iimarky1234/LoRa-Weather-Station/docs/Cheap version.md

| Components | Price | Quantity |
| --- | ----- | --- |
| ESP32 | 160k  | 2 |
| [DHT11](https://hshop.vn/cam-bien-do-am-nhiet-do-dht11) | 27k | 2 |
| [MKE-M24 Ra-01SH LoRa](https://hshop.vn/mach-mke-m24-ra-01sh-lora-module) | 135k  | 2 |
| [BH1750 I2C Light Sensor](https://hshop.vn/cam-bien-cuong-do-onh-song-lux-bh1750) | 35k | 2 |
| [Grove - Soil Moisture Sensor](https://hshop.vn/grove-moisture-sensor-cam-bien-do-am-dat) | 15k | 2 |
| [Anten Lora 915Mhz 3.5dBi](https://hshop.vn/anten-lora-915mhz-3-5dbi-70-20mm-ipex-tx915-jks-20-fpc-antenna-ziisor) | 20k | 2 |
| [Mạch thời gian thực MKE-M09 RTC DS1307](https://hshop.vn/mach-thoi-gian-thuc-mkl-m09-rtc-ds1307-real-time-clock-module) | 35k | 2 |
| Mạch ghi đọc micro SD | 15k | 2 |
| **Total** | 442k  | 564k |
