iimarky1234/LoRa-Weather-Station/docs/Functions.md

## Environmental Sensors:
- Temperature, Humidity & Pressure
- Wind Speed & Direction
- Light / UV Index
- Air Quality
## Communication: LoRaWAN
Node -> Node -> Receiver -> Local Server
