iimarky1234/LoRa-Weather-Station/docs/Useful Notes.md

https://randomnerdtutorials.com/esp32-i2c-communication-arduino-ide/
https://randomnerdtutorials.com/esp32-s3-devkitc-pinout-guide/
https://randomnerdtutorials.com/esp32-spi-communication-arduino/
randomnerdtutorials.com/esp32-lora-rfm95-transceiver-arduino-ide/
github.com/makereduvn/MKE-M24-RA-01SH-LORA-MODULE
[APM10](https://drive.google.com/file/d/1BAugwM-Li-jGMpyRHw0AnCDVwf6W3W4X/view)
https://github.com/kchwz/APM10
[UV sensor](https://wiki.dfrobot.com/sen0540/#tech_specs)
![[Pasted image 20261008172738.png]]
