iimarky1234/LoRa-Weather-Station/Excalidraw/Weather_Station_Block_Diagram.excalidraw.md

---

excalidraw-plugin: parsed
tags: [excalidraw]

---
==⚠  Switch to EXCALIDRAW VIEW in the MORE OPTIONS menu of this document. ⚠== You can decompress Drawing data with the command palette: 'Decompress current Excalidraw file'. For more info check in plugin settings under 'Saving'

# Excalidraw Data

## Text Elements
LoRa Weather Station & Asynchronous Wake-on-Radio (WoR) Relay Node ^2RUIXauE

Dual-Role Architecture: Weather Station + Low-Power LoRa Range Extender | SX1262 Hardware CAD Sniffing | Listen Before Talk (LBT) ^5ap9Bvtf

WEATHER STATION & ASYNCHRONOUS RELAY NODE (OUTDOOR HARDWARE ARCHITECTURE) ^zSuPotmF

1. Power Supply & Distribution ^BuRDiX9T

Solar LiFePO4 / Battery & DevKit LDO Rails ^SqDRI4YI

• 5V DC Input: Solar Charge Controller / USB-C
• 5V Bus (Pin 21): Feeds 5V Sensors & SD LDO
• 3.3V LDO: AMS1117-3.3 on DevKit
• 3.3V Bus (Pin 1): Dedicated clean rail for LoRa
• Common GND (Pin 22): Star Ground Reference ^p9uyle8T

DHT11 Temperature & Humidity ^n0Sk6EXF

1-Wire Digital Sensor Module ^xYWzMHa1

• Temp: 0°C to 50°C (±2°C) | Hum: 20% to 90% (±5%)
• Pin 1 (VDD): Connected to 5V Bus
• Pin 2 (DATA): Connected to GPIO4 (1-Wire)
• Pin 4 (GND): Connected to GND ^oXQNABsF

BH1750FVI Ambient Light (GY-30) ^3kpwiYuP

I2C Digital Illuminance Sensor ^3EP6RKSI

• Light Range: 1 – 65,535 Lux (Calibrated)
• I2C Address: 0x23 (ADDR grounded)
• Pin 1 (VCC): 5V Bus | Pin 2 (GND): GND
• Pin 3 (SCL): Connected to GPIO9
• Pin 4 (SDA): Connected to GPIO8 ^N1Z60F3e

Soil Moisture Sensor (A0) ^f5IFRlAg

Analog Resistive / Capacitive Probe ^zcOcd1Qv

• Sensing Output: Analog Voltage (0 – 3.3V)
• Calibrated Scale: Dry (Air) ~ 0% to Wet ~ 100%
• Pin J1.1 (A0): Connected to GPIO14 (ADC2_CH3)
• Pin J1.4 (VCC): 5V Bus | Pin J1.3 (GND): GND ^gcI2DZCH

2. Main Microcontroller (MCU) & Relay Controller ^uwbLJkkV

ESP32-S3-DevKitC-1 (ESP32-S3-N16R8) ^xjQM4z3q

[ CORE PROCESSING & MEMORY ]
• Xtensa® Dual-Core 32-bit LX7 @ 240 MHz
• 16 MB Quad-SPI Flash | 8 MB Octal PSRAM
• MicroPython v1.29.0 Firmware Runtime

[ SLEEP & WAKEUP DUAL-ENGINE ]
• Deep Sleep State: ~15 µA ultra-low power current
• Wakeup Source 1 (Timer): Periodic Local Weather Log (10-15m)
• Wakeup Source 2 (Ext GPIO): GPIO5 (SX1262 WoR Trigger!)
  Wakes instantly upon detecting distant node preamble

[ HARDWARE BUSES & PERIPHERALS ]
• Shared I2C0 Bus: SDA=GPIO8, SCL=GPIO9 (100/400kHz)
• Shared FSPI Bus: SCK=GPIO18, MOSI=GPIO11, MISO=GPIO13
• SAR ADC2 CH3: GPIO14 (Soil Moisture 0–3.1V)
• 1-Wire Digital: GPIO4 (DHT11)
• Control & Wakeup Lines:
  - LoRa NSS (CS): GPIO2
  - LoRa RESET: GPIO3 (Active Low)
  - LoRa BUSY/IRQ: GPIO5 (WoR Wakeup & Handshake)
  - MicroSD CS: GPIO10

[ RELAY & LBT LOGIC ]
• Executes Listen Before Talk (LBT) prior to re-transmitting
• Appends Hop Count & Relay RSSI before forwarding to Gateway ^2WJ0Mlcg

DS1307 Real-Time Clock (RTC) ^RmIEyMq1

I2C Timekeeper with CR2032 Battery Backup ^bt9r1vZ8

• Bus: Shared I2C | Address: 0x68
• Power: 5V Bus (VCC >= 4.5V required)
• Battery: CR2032 3V Coin Cell (Maintains UTC clock)
• SCL: Connected to GPIO9 (Shared with BH1750)
• SDA: Connected to GPIO8 (Shared with BH1750) ^qBBURwjV

MicroSD Card Breakout Module ^HC3TPzkw

FAT32 SPI Flash Storage for Offline Logging ^DgAPDlgm

• Onboard: AMS1117-3.3 Regulator + 74LVC125 Shifter
• Power: Feeds from 5V Bus (Dropout margin)
• Bus: Shared SPI (SCK=GPIO18, MOSI=GPIO11, MISO=GPIO13)
• Dedicated Chip Select (CS): GPIO10
• Logs both local weather & relayed packets offline ^TLPaZ0Ev

Ai-Thinker RA-01SH LoRa Module ^NChoNRZ7

Semtech SX1262 (Wake-on-Radio + LBT Engine) ^HYa109vp

• Frequency: 915.0 MHz (US915 / AS923 / ISM)
• RF Power: Up to +22 dBm (160 mW PA)
• TCXO: 0.0V (Standard XTAL) | DIO2: Internal RF Switch
• Autonomous RxDutyCycle CAD Mode:
  - Sleeps 500ms, sniffs 5ms for LoRa preambles (~200µA)
  - Triggers GPIO5 IRQ to wake ESP32 on distant transmission
• Listen Before Talk (LBT / CSMA):
  - Fast ~2ms CAD scan before TX to avoid collisions
• SPI: SCK=18, MOSI=11, MISO=13 | NSS=2, RST=3, BUSY=5
• Power: Strictly 3.3V (ESP32 Pin 1) ^ZwBtSDl9

915 MHz Antenna ^KllHag9v

IPEX to SMA Whip ^SqHOkuTw

Gain: +2 to +3 dBi
Omnidirectional ^IKiVA8Ye

50Ω RF ^9FIVsbce

GPIO4 (1-Wire) ^mhQojBEM

I2C: SDA=8, SCL=9 ^ryzXF8nV

A0 → GPIO14 (ADC) ^12SsMg8L

I2C: SDA=8, SCL=9 ^KdKrjUUG

SPI (18,11,13) + CS=10 ^Me33xTcz

SPI + NSS=2, RST=3 ^PoF2DYsQ

WoR WAKEUP (GPIO5) ^Nhw0Clew

MULTI-HOP IOT NETWORK ARCHITECTURE (WAKE-ON-RADIO & LBT RELAY) ^clV0jEVK

Distant Sensor Nodes ^jUGkhKC9

Battery Powered (18650 / Solar) ^BwNh4p6y

[ HARDWARE & SENSORS ]
• Soil Moisture Probes (Deep Garden)
• Weather / Rain Gauges / Well Probes
• Ultra-Low-Power MCU + SX1262/1276

[ ASYNCHRONOUS WOR TX ]
• Sleeps in Deep Sleep (10–60 min)
• No clock sync required!
• Transmits with Extended Preamble
  (~1.5s Preamble on 915.0 MHz)
• Guarantees sleeping relay will detect
  the packet during 5ms CAD cycle
• Out of direct range of Indoor Gateway ^UAMYDm7A

LoRa Hop 1 (WoR)
1.5s Extended Preamble
(1–3+ km across obstacles) ^59qEiON9

Weather Station Relay Node ^whQdg7df

Intermediate LoRa Range Extender ^VjacY3iX

[ OPERATIONAL LIFECYCLE ]
1. Deep Sleep (~15µA) 99% of time
2. SX1262 Sniffs 5ms every 500ms (CAD)
3. Preamble detected → Wakes ESP32!
4. Receives Distant Node Packet
5. Listen Before Talk (LBT):
   Runs 2ms CAD check to ensure air clear
6. Re-transmits forward with short preamble
7. Local Station Action:
   Periodically reads DHT11, BH1750, Soil,
   logs to MicroSD, and sends local telemetry
8. Returns immediately to Deep Sleep ^qwQfbzJC

LoRa Hop 2 (Uplink)
Standard 8-symbol Preamble
(Relayed + Local Telemetry) ^m4u4vdSg

Indoor LoRa Gateway ^Igzptiyn

ESP32 Bridge to Local Wi-Fi ^s0xBVVWQ

[ HARDWARE & FUNCTIONS ]
• ESP32 DevKit + SX1262 LoRa RX
• Mains Powered (Always Awake)
• Demodulates all 915MHz packets
• Separates direct vs relayed packets
• Appends Gateway RSSI & SNR
• Formats JSON Payload
• Bridges packet to Local Wi-Fi AP
• Publishes to MQTT Broker ^YW7YlnF3

Wi-Fi 802.11 b/g/n
(TCP/IP Port 1883) ^Fo1SAf4b

Local IoT Server & Automation Stack ^CcyGbGPt

Home Assistant | InfluxDB | Grafana ^f6NIfh1J

[ MESSAGE BROKER ]
• Mosquitto MQTT: 'weather_station/telemetry' & 'relayed/nodes/+'

[ HOME ASSISTANT ]
• Entity Tracking: Local Weather Station (Temp, Hum, Lux, Soil)
• Entity Tracking: Distant Soil Nodes, Garden Beds, Well Probes
• Multi-hop Diagnostic Entity: Relay RSSI, Hop Count, Battery %
• Smart Automations: Irrigation pumps, frost warnings, alerts

[ INFLUXDB & GRAFANA DASHBOARDS ]
• Multi-node historical trends on single dashboard
• Microclimate comparisons (Backyard Station vs Remote Garden)
• RF link budget & signal decay heatmaps ^0TVC7NdA

SIGNAL COLOR KEY & ASYNCHRONOUS WOR / LBT PROTOCOL: ^7EgTakqk

• RED ARROW: WoR Wakeup IRQ (GPIO5) & 5V/3.3V Power    • GREEN: Shared I2C Bus (GPIO8, GPIO9)    • PURPLE: Shared SPI Bus (GPIO18, 11, 13)
• CYAN: 1-Wire Digital (DHT11: GPIO4)    • ORANGE: Analog ADC (Soil AO: GPIO14)    • MAGENTA: 915MHz LoRa RF Link & LBT CAD Engine ^yA0SkdjW

%%
## Drawing
```compressed-json
N4KAkARALgngDgUwgLgAQQQDwMYEMA2AlgCYBOuA7hADTgQBuCpAzoQPYB2KqATLZMzYBXUtiRoIACyhQ4zZAHoFAc0JRJQgEYA6bGwC2CgF7N6hbEcK4OCtptbErHALRY8RMpWdx8Q1TdIEfARcZgRmBShcZQUebR4AVm0AZho6IIR9BA4oZm4AbXAwUDBSiBJuCB4AJQBVAEkADVwhAFE00shYREqoLCgOssxuABYABn4ymG5EycgKEnVuAE4e

Ze0EngA2AHZk/eWADhHknYS5qQRCZWluZLjzoshrZWDuCaeIZihSNgBrBAAYTY+DYpEqAGIxgAzACMOx4uEGkE0uGwf2UvyEHGIwNB4IkP2szDguECOWREGhhHw+AAyrA3hJBB5Kd9fgCAOqLSTcWEXdn/BAMmBM9AsioXLE3DjhPJoD6dCBsUnYNTTNCwsaKsqY4RwerEeWofIAXQu0PIWUN3A4QlpUuEONlzGNdodnzCCGI3C2h2OIxGF0YLHY

XDQfE+IdYnAAcpwxHyEmMeDsxjstVsLoRmAARDJ9H1oaEEMIXTRO4itYJZHLGs0XIRwYi4Qt8nbLWFHU4dztBz5EDh/W32/AXUHo73cEv4MufPqYAYSAAybGquFQnJC6iYqAZrbDqAAZKgAILMGAcbCSX4cYTMTe4AHOTjOdeONioAAUnLXAEpUGqIJcBgVB42IJALU4KA6UIIxxF4LNPmhaCADFcH0GkNVQfl536U8iGUcN0DEHImEpEMoHMAgC

OuYiIEw4hiDectQiCQhZRmZILj0HJcA4pgbTQd0x0+MFrg4ggABV+kqVd103bdJF3fcqM4Y8zwvK8b04e9H2fV933Yb9f2qACgPwECwLYCDKUHBAAAkrhuJccPiR4lRaKA13COCEJ+IQEGzHEsEqXAxkpSRQhkxdlw44di1LILPnICgYtciAICKABfSYSjKCoJASXA4GWAAhegoGhSlugQ6BZIuYY0HGC5sL9C4FmIJY0H9LZ4mSLYtmWE5kgSZZ

Tg8splOuW5NT62ZPheMUdQEH4hTxMFIRGM4EiGylUXRPVsVxEFNsJcgOBJMlsgGC0aXpRk6olH0BTWrkeT5V6OWFR7KmeylpUkF1jRW5VVXVPltQuI6DSNApzWQq0ECE1ARMdY7gZHD0lS9ItUF2HYM0myBozDGZgyYGMOHjK8ENhLYuwSUaeGSUGc3zYI20S2dkqVCtjurTIbvrBGlSbFsuZwjsu0OHtlj7cd4qx0SlQnAE8ZnOclQXDLcyEAg3

xBBAz1ESQ1AQbAoBEBA0C3VtlNIPcojUjhUAAalQVcKGcAAFNgKF3eSN3XDhlGN1pF2yCDHYAHz3RpYW2HhUAcsliAoa7UEBU9cz3DhCGhalQ9QOO4u+bJUDKhAUMCVApIIP5v2XMqpL/SkUJyWD4L5bjkLQjCsM+vDF1oojKlIvpwQp0gqPcUf6MY5jIM+VEwnsvlcKVXiogE0gUbRsTSAkjhpNkiQ9YN6ojZN69zct63baUlTncPD2vd9/3A7X

YOXnDyOQtjvHROWxk6p1IOnTO2dc50nzoXDiygS6exzH0V2Vca7G3rvgRuX5m6tzsgJJyM1XKwnchcLyPlWDdzQAFXmBUQpNXQLgWEkVor9DikOacSUpSUHSpULKpRcpFHypAQq6BAiWwAPocAcgARTgBwEYDkADiEjUgXFqpUcRURQ4sU+Aw1mrUN6g06t1KWLVPjTRctwQ4yYyE6IQqDQUAINoEnQBCYauBkiaEOPtNEGIsQ4hcZCaEhwSzQmw

O3e6IoxRfBBJKT0b0EDci6ryCMX0hTRKenEl6KVhAyjlO8C4Ko0QQ01FDT4MNDQiwtEjfeo50bOgKWgYRXR4AIWSE8QROMEBTjQFsVm/pljTypuTKMlMww00TJqPYOxjidkOEhJU7MCy9NQJrWhKJKyC1rLkeGjZmytlWfCTs3ZCby1hP2VWSthL1IHGwScGsuGfA4hBBhEBcA8BYcwdK7CEprKSjlPKzy8YQCMHSIQfsoD6FQjVNpvQGp6O4LYz

42FE7EwgCY1JqBDhjBGNoQ4ax6aJGWDsLYu1IxKksbNXgJCFqeXsYUhJ30gkSAhLCBAawvG+MOgEk6+JegXSuuSW6yEom/WZNktkiTkmmM3mUJxP1RRZNZOjfJrpGVKmKWqWAkNQaVLhmgBsiMMLIzxgfJUvLMY3OxvKnpeNtr3BOMMsmaSxmhjjAmBCu0TiwgSAkAl2Y8wrMeTzcsWyazCz2Z8cWhy8bHJlnLBWA5rmo1uare56tOGhuHhlTkrR

TxSQcq0aoe4pIFvqAAeVjBpU8dIACasZAQOWqFWittQ6SAVaMuU8dawIVtzK0b8bapK5grRWktDlTzVFzJyKdg6p1NvqFJVogIpK1GqK0NuUFO5+XbNuqA6FML4FReo/ChF6LBGhCKpUlFqL4HnpUReui+ZsXXpqdF29+Kyj3matNZRxL+FPouSoeaC1FpLXSMtUlK3VpPLWhtTaW2xjbR2jd3be3IYHUO2oI6x0TqnTOudZ5qiLuXau9dm78Gyk

IVYzUpDFpCG8kBSh/lSCBWCq8sKaiLGsNiim9Z3C0pn3QPwsAXTijAs0RbKAEilHQmYAkAA0ggBIKiEiwp6BILRS1l5KgYVsUGqKyUdQ+s1LUFwqXEOM4tBlCp0nONOq4iAEJiAkrTFsbl/jKwsrcdCauyRsA7EibSTJf1JX2aSaZ3gEXQsSpVbkvwQMmmoFBlq0pOFylKn1dU411pf02sgJa5LLToBwrQB0zo4mBB2t9H6lmcqSbjM4KMm9TXqa

ep7sNBZOwRjLDZkGzmqyBMr3DULOsUaxYHMlvG05vYLmKw4dalWZQ1ZDaeUs+hYURhfJ+fxgFAigVLJBWVIQ07CCNGWFJDTdUdaUgYWmQx0ydgmZSTMEYhxtCwmSBcoaCIyUgPRZZmYtL0U6Y1fKxJPnnOrHGGMXTZQDpeeOlDokl1STCuCw9JVYX4s42lVFhrXxEmxfFOFhLaqQZFPBjqspeqsSwxy0qS0Jq6kFYgEV9VS2BQ1bQH6v133nXNdd

a1917XaZJnGh2cYIxFkFQGwgSWw2+ajZ2YzsoMbpvS1m+cy5K2U3mpWxmtb2btbCYgCQ1AfsA6O3BXAHwoETy5mQUfTQjGyb7q7nTZ7fcciHsHpqU9I9z3jxuuRaes8aLB4kE++HKJX0CSTDxaCX7BL5eW5AADkl8C8IkBbq3Kkmz240k79khBXcuyo45Zy1KQdkMYxQ3d1C2MbPKJtiQuB1MWd41AX5WatZlFSjnkTgKhGSYkHSAAjrmao9QRh1

vqNd+FwHGrcAeyimYYxCeYpmD17Qsz5bbWTCS/7Fnq/ENB7ZlLEWocQkP7tZYnmjqBMcwK4k6ObqY5J7E3HEPvoyqxYTgql/v9KqklpzlfmJNTqiplrqPTlUhNmUMznlsrA0sQFaqmmzrjKvumFsE6m6iMsLmUKTB6uLs1KzGmO9oNIGhzArsbv3psgLBGuNoaqLOrlNkclrrLGckmlcothgenhAKtiGvQfVMBuPiCGSEgqhAgD7BWiMKgAoJXK2

JPA7qgPmPQIpmoJ7KOoBPxLOO3NBJ7nyBSogf3Eeiejmg+hIBPGHm6hHvelHugDHr4mvAnmUknnxLvKzgIZnifNnmbnSBIY7HFNIbIfIYoWVMoUwKoeoZoVANoRWroTSHkAtlXkQnyPRp5PXsxo3qgDQhxqFO3h5l3t8mwntibgPjwmbqJuJsIuUCCqVEIEqocFduomVugLdivmgD1o9rwHSmUNvuVr6vijwGMN9v0ZAEDn0h9mcHYq8A4tfi/qy

uypypoI/ryijoKu/hSHdCFuKqTj/qtH/gTjFvsd/vEhankmAZTpASUjThlnTvqPASwTUizmnqgegQbtVqskzN9imILsRCYY1qLpMghKSkzH1skEcNQcGn3i3vzDiNspGi8dGuwXGpwYmvNsmnwV8YIUbsIS3rdhIIAEQEqACQAAamoYCKgPUBwHAIxmgIEZZI7ICFFKQGHFnNBL8LSLuIoe2mVM4ICAADocCkkUmVxCAPhfg+wcQ0p/hoDSHegPj

il0jZCCAsAaR0i5zLijoimknJApCUk6kVpoCngACydIsIVpOwzgBpyQqA6ksRagepqAdplJJ2UpMprssI8pah3o1EhYqA2AwQ1gqA5ANIayYIns38LpwI+g+g6kSisYuc0pspPAPAvp+4jsSivKgE1cTA2QiYHuuRVp+6fux6dwgeUAVh6Al616RBTA9hNZDEJAS8Lh7EnEaAQynwn6Xh7xh8x8QGGUYplJuY1JtJ9JUAjJQRWcbJHJwIOQ3JwQj

sfJdIApwpopZJ7pkp34XpcpCpdqyplJqpl0YID4J4WpCRLpbpCRppFpVp8ItpKQDprsTpUA15hpEpnpspPpaA+YjgeAgZwZIQrs4Z+AkZwRMZm5cZCZrsSZKZe56ZmZUQ2ZuZQEfm5IRZ2JaRtGbkEx7y2RvkVCeRzeBRbyuAQWJRu2fBSulRQmYhw+B2o+R2UmkirQhwMAZUhwcA1QMiEiD+bRmmYi0mYOXR+MhmdwyKSogxqAIw5mFiZ+fIIwF

+8x4ORx60SxbiYwY0g0AlK8fiT+fKZ0biFs0IxA0Ineoqex2OcWFxv+Qo/+LW9lAIwBZOlxiW6BqWUBuq0McBBqJorBkASBpqKBCWjS4BJWGi5WnS3OqyewpwOKAJTlwJVMoJ1iCQicPA9MVBzy8uiu62COKuyJAV+yEsHBJyXBc2uukAg4fyuJQhcJZFYUPiVFZRNF+2Ymh2BUIKHAYwdIfwWwrQjQMKglN2CKem2BvRA0QJGKUWiQBp/Sw0jMf

qg04wsukxilEYteNmqldmTKGl/KrKYwZK0IMu6x3mml0AWx10OxVlWOMSIB+170r2AeT1iqD1blA+VxnlVOdx0BjxTYzxJVuWIVXOYVaByWuJWBzUywGVX2SVhBKVEyHW769M4wLM/xuVNB+VFRDBiJTBuyKJk2ZV6JFVmJ1Vgh+uf6NV+JjVOalQuYDkUkVpdcmQiA5AVstcJ4DkQgjEEMxZxF8IZZA8FZr1puQedEIeZEU8dhd6zZzhrErhnZO

EH6yefZoVmqR8gG/hDFEAjNzNsIrN+g7NrY1sGkPNfNOqqRNGNemRZQ5CORxF+RzybejCellK3eve3MIhg+1RI+pQdRoiEAmAdanIRgZpqczCo1S+9ZkA92El5WCyL2sqZK2guKfYNiY0CQaYvclKm1Ktcxy0ixh1bid+e0rEPKF1JdV1b+N1sdVIYqNlBxdl6lz1sqpxTd5xOS7lFOalYMf1PlFSflauQVtS/Z7l4Vbo1NXwPOvAx+sIhwCN0W+

ByNpBOEqYTMhMpKM1yyg2BJYajBY2hNwNxNsa7YZN3BWJvBdV09DV3thJZusIzg3ItcTuqgUQ4FJ56pqAZpNk9oseVIhhJZM1HcB6ItFh4t1ZjhEANhMtIuTZ0DCt+lStdMoMvZ363hRSWtWeQ+5uz9hAr9EkH9e4apUZv9xA/9leNtxCdtzwhFLG3AztG2nG7ep4O2bVfytFhWVRutNRXVIiIKbAjQMisYp4ZUzAI1847Roh9d92FN2EclxiUW9

wcQ2w5KgO+dfqhdCxb1N+Kx40axFdSOz+1dqOQqH+ux91yqLdROxxL1OEHdH1hx7O31yWXlA9tOvlTx/lRqTOY9GtX1GMkN090NZJuwJwi9K9Quy9IuqVKNOExwICmVSdWNsJ99B9+NR9I9EAGu5VCal9FNtVATNNDydNkDlQpJMkxtCoAADdSd5GSWMHU9+AAI08B1MARxwW0RhjAACkeRn4fW/TX4LTCQvTf4Lpe5htX45JuYuYvpC5sols3oA

zW5X5kzaZ34uYBap4CznASzgZDTSiPsla8hX4T9L9CAEzm5e5Zz8FezHABzKzRzyZBhO6gthOoD5Z2EudZQOszZdZFEjZctiDrZz6CO8eyt3ZW8atGD49/62DfhuDlTbNtT9Tn4yYzTIz7TgInTKcvNPT/TDTQzrTYz1zpJUz34sz8zaAiz0mzzGL25zAGzrsycX42zZaDzTzxAqzxzpz34FzBDVzLLsl349ztL+z9LPLLzuYVD+d21WRTGRFrG7

GLtLDjCZU7DfG7VuN7OPDGUfDzF3VrFMmy40IqEcAAAUqePoAAFYSJfaL5aYiUMpiUGa9EZXooyWKOn7pGajKXaN90Ko35jCubvYtX6WV3I6XUQjQgwjmVIiWOuXOMKqOWI22MZJnGPU93XF91pb3FagA0M4IGj1vHFMuNBMRVPCtJCUVZMXdKrLDTJgwFI3RMzXEFi5TLYrjS9a+oU2720H70jaH2q4ls5Nonn35NVULY31s533/K6svKFGMKAh

as97lFhD+0SYsUSDJB/BwALB1oQpOsdHjVDCTXr686pjJ1Yqpg7B74djJD+gjB3vJCBi+u4VZW0PvKX6OKQ4xtWkJAqbu0QtRsmPGU11o512f5ZufWt2Rb2OAHE6wfOOAw/W3Har/VeOA0+OBVUj+Ng0T0Q3gFQ2z2+pjTDRL3tttZpU9SJDHA7T9bY10HwlFXMEn1sEk2Tva48F644m3203pP00SBlQOTwjJioTkn1Bnj6CaCEA3RIIuRit1q2l

jBbo+4wQlne5M5mH+4OOWHQOwNAszwguS3R5gsAOrwdl0yq2eFwvlu+FDmVCifidjCSfSc2tycKdxRKdfhKIqeszqe8E4W234UO3KuMOkVqvLvvKyutXaucMFXcP0UGtbuB0grJCtA+xbDVCKZ0gL7R2Ehntx0XtKjYR+pb4E6zL4oMyJAL1/EJDbQfs14qVF26Mxtl0gdx5gdGVOZmPbH13UjWVOM2OpsnFvXJs2NoduO/WYeD1ZbD1jvBWYPg2

fEhOz2jFZWw1UcAm0eoA9aHCJwErbAwl71lOFUjvFW+Ocdn3TIX3TvYmzsCHztcMyOVD1A8DUlv1qAEA0m0i82SS0wkOnlwOmHvN0wgO6ei36eQPNlGfh6mdjzmdMTgtx4oOQweE7z2eEcIuDk60ZQfdfdEO/f1D/eYQnxA9f2bTW3yvfvhcMNN6qvMMxe4DtDxfrs6s+36t8Jpdj7oCxiwgABaBmqEyQADUVp7y+iK3R8jSKsxnwMlqYYwe+Yxa

KzXrkfoe+rXOjeOzKAHHKBj510bpj11GOSbKHo3+OiHjj1j3dgTvde1mq3lnjQ93j2Ty38LhWlYa3mBs940uwA0O3UTnbCEh3iQCI20kTSyeVLHGTVYBN2TuTpNU7OuM75bL3SXb3JJin0guhocNsOEqAgAyAT4znBMwJCexCCYDfiAgEBl4c3ejks0mfdnhMSBCugKiYAszfg5zT6oCGWN8ivTPkmAi4u85MuIKIVivJm+nwUiv2lfh0iAjLhct

Su8snMVrLAitnNam7MSuPNr9HMb8Rs6fg8bzC3mGVkGdme1nVz123pzygso+WeQsITQtlDoOp4OeItOfZ8+e58hww4moYvqX2oDl9K+1fL8LXyICaAG+xAJvoT1b5kA5Qnfbvl+F74loB+8AoflS1H6+lxSHpSfpsz84z80Ac/G5rKQX5L8V++/bluv0rRb8KBrsHfts1X7LNpWn4PlhWhP58cQuNDMLvQ1yJMM6E6rd5JIw9qlEEu53ZLrg0NYB

0+e7OaTBIktaaAHIgIZIMwBYAOtKKUjISooMtiiVpe4lXon6CUb2MfWClP1irW15Bt/21dCEGSk8Shsje4HJzLGx2B+YEAOgpnI3RG5294OabGJs5Xeq28AYrjcAu4zm4u8FubvJbgR34IfFis1bUrLWxiqehZ6hwDsL1CD6xNV6XbUYoGD2CJN1q5QGPkO2VyXd2O13SAEn246VVU+j3dPoJwXYiEl25FJRGuy9otCEAvPHdugAsr1BUI1Qe9Mo

BPZvcxKa+Mrr6FWA3tgcBpQ4ONAhIvtMhWoSjpYM/YKt7av7YuhBwhDJBoQSTT5EY0MqbFa6ZvO6pN38EZs26ABG3jjim7hCbiTvDxg8Ww7FsiaiBeIbiQ5xT1feqyQZNtApodtkqDAGjvEy1A9ZGuZKf1Kd0HbSCIACJePlkzHa1C7uKfXjjVSppztmhr3IkugECIRlf6yCM2lT0djoC1ObzTToLW05g8wGl/MWn8zPQ38YGoeUHsCQQbMikGL6

dHu+kx4p4f03/PHrgwJHgUiR3wEkaQzJGngKRNPKwZsLoZKsGeJFJniIJZ4OROhG7FvL7V4a9DjWEgIwNgArTYBiAsIGRPQDGGdEjBkwqYKvnpizCtqcQGxGcC+wvtCYb7J9ur0Tw7U2uuvA6rsM64uDeur+KDucJ8HDdQhEWQIUh2+iXCwhHlGbhh3SyFs3hQNaofhzLY48velbX4QIVCazJfUV9BsqLhBEds9uwCE4BlXTD9syh8IxEUiSqF4d

URUse7g0OvpNDSmQncphIFPB+E2ACCHIt8EICMAFCWcEqHcSHHGwfYvwTQAA1AZGFNQkPX3OAyHiw9DOrI4zhyKR5OELO7ZN9Blj5Hq1MxyoH/vj0qA9iCAfYvMqwEHHDjFCtfanBOMtzTiAG9kahhkQEGKihBUXZnuRQK48ZJBHPRLrq21Gpd6227PUegGUDYAPuuYQXk2gtHFdg6q+WXjLzMGmJWY6wCaJ6N5w2DHewQvRgby5THCNil1frtB3

N6d1s2wQqMXcNspXDpuEQ2bkmJbYQBsscQjMQkNW7BM/heMElJsGOA5CixcTNeo13pgLDqxzHcoRd0yajsPhNQidmiJ46FjMR/HbER2O6FVkKmwPVgMXArSMZJyppXsQgnJIggogHJL8GMBAFukm+0A+vrGj3DuAC+uYUgKBHQEEMAIAAPxSxEtPwW4eIl5MLa9MRWlrEhNM2lFsDDmnAjfhch75jkeAEiJtMkCb57kQp2gM5iPzH5rNCBccFKSQ

gX7itUA8FSkfOJwifMoePzKsgCzv4bjEeC8HcYrWs4rADx2PTiZrSFFm5SSX9eBKgD0myAGSZ4IyagBMn4AzJxsCyVZMNI2S6+sA+yXSEcl/kXJPfdyagC8l9NVmfklaQ8SClMDUAqUsKWp1oGH8oplaGKegLikJSHISU4KSQnSl4Dx+X5Iga7FSn5TSBhU15rKNwryiCKn4p2t+NVHkVLWGoznlqO54SA5B4EgRiawkT6BLWS/L7ICH0ASIsqYw

7TK6yMFMwE6OEazNJSiyVjsJ+3d1t6J174SY2iQfpAgEMaRtjGQY1lNXAOGFwYOlEuDtcIQ6mIZqQBC3vRMeF5tnerw13jh3d5fDp6Pw7gJFXaJ1tOq6Q1ZAlQzDv9W2gJXbuCP6T7A/QCyEoQOxxoiE6xCfFEQpObHojlJlNVSc9xxGZ82hYURTEDKAmbswJ6XSoEIAoCaBlwlrP4H8HJIISpeE1XnOYimFPZ7RslMYOsF6wZVZk6ZNRgDnxlfs

wu2w9rvYPZTjBcA1UYiVXQg5kTQxiBXwRGLeo0SJunMuMQ7wgLPCohfMmIQLPYnIEjxIso8aExfa7RsZQkl1EEPllljlZmQnFIbI1mx9h2Mkq7o2L1kzZ6hGIo2U93HCmzdWeIqoNoB/pfof65gX4NvCXK7gvwZpQELUAAgngLIVkBcmtB5JsjAGZ/aZBfz06E5/ma46WjVMf6cj6pyDRqbyJ7Kwsv+R4xzqeIkBxBp5spM0nPPuRckQQy5b8CvL

XkaRN5oEbeYvL3mvjaeH4hvL9JVEiJXa7yZcFbPhEgSeetshQZgFtYyIzSIwIwMkAnwezZGSKH2TaJ6aVd7GLMPqAzEJhZU/UpKeEDNSmIF0iZtgvXvYIDHJzjeqc03hYwuF5zIx43X0S5T4Xk5c2eEjPLzOTH8z3hHHUthXNamBNJ65bUJrDVGgsTgR6bUsfE0DCAc9gMuWEZrNY6VDj6aYpsQPPJpp8jxGfceWblaB0gfY9wZwHSGSDOA3ygIZ

wNM1sX2KeAji5xQLxy6HAgutIkqYnCPnQ8T5TIrcSyPPkI9L5kSrkRCx5H7j75dnR+fIozwnjcGnihxU4pcUIANCagNxR4rsXZLfF9MaoAErlZyi6eggmBS3nNnt4zSSCzsXRVkG6jIZr8zkJazGBml8A2AUYYV0l6ELvZKEvol62UbyxtABmSXBoysHuitegbMRSzIImrFAxpwkMTwrDFWN7hVwsbtb1zlMzUO3MxZfmyw5SLUxeHD3uWyrlpKZ

6HBGZL83lkliwRa9MlLLFhoyx9FXcioT3IbGlVbu+spSYUyxEmz1JuIs3PkCzjjpB0PsFtICFsX5dYwSiDSGaVaBmlx0vaU0C6UaAoJmAuAAAHVqF9Y+AQUmCGNgOK5O8RZcI0B2CoAAAArwHGA/0HIRgF0vTB/plRUAMifWMQEcUnNUAqESyMwEkCIJDg7KnqQYPAo+w6Q1Qc0i6U/nYBfgPsGAOoHUj0BaU6wSyahAIb6AM4tcaoNiCohZARSI

pCFXSGXCtAsuGkWdIplaC1AfYahWoKeGXDOBWgiK+oLGEHSYrNy+YBAHAD3DBBfVTsQ5GgA8m+pUAAAVtPCoB7QRIZwKCAoCoA4An8R2NgBEDCoXSnIJ8AgCbB7hhAogY2NMykiEAsgpAX0j7CYDsAAK0ZdwIpHthfwEE5zMYO4oSD6Am+magEDmsCIiAxAvAb8BHHiJcDZ+G/CvovwThJxNwa4OuFrTDikAAAhNc1QD6RwgqADiN8GsBQBj00ap

Na7Agh9BLY3UxwGupyCowbIxsOAIEAwiaBggxqjgBCsnTTpZ0G6SuO2lsUaQfYxaeoD7HAxOqO0XqzqWyRWaE9LJHpRktswAC8XAxenuGX4QaN+ywAVtqAUCw4/gzKpvnSAA08tUIdi6TiBug2KZYNJ0qDWivy4EaK0pZH+vUDpAVpSNX2F0nSCnRng4pWcS6WQOik782AhIjjeKNrhjAi+BpWEOSSb6CtCG79AgKxv5bssmaVpGyT/PAonh212a

v1ewnCDIARSi65wNGQUixg6QHaKAXSCHWVoeAam1ABpqDido6QrQKSOJorQL9Tw+64cV7AXUmbNNG4MqO2jrQKB6gvFazSOtMhLqc13NawEaCigAgnNGm+Vb8EvKAg6Q1mrUDeohVoYe0GkXBJ7ArRKJ6g1JP9agAjgWxGMy6suCgkrjVxSVdcBuE3BbgARz17AR2A00CDOAzGmEGQPAhdKng7cUcB8A5BVCckDVQC4CKBGqA6bpOM49BBBV1WOB

i4RzQ5BnGmAC06YZUpcfSNdKVToGgLGJZHivnP9dxbhVAHLJgYPyBRT8jJeCshVPqYVFaOFYNsRXIrUV6K1AFluxVql8VhKg2MCFrjkqtCVKmlfSp4CMqI6LKzcmyrNIcquVuAHldhv5WCrhVccUVUDvFXEMpVMqs0nKq/lKqVVrsNVfEA1X8rtVuq42PqpyDFqEA8WvcOastXybTwNqu1Q6qdUuq3VHqu7S6R9V+q6QAa5nc7AL6hqK+ka6NSNP

IBxr/Yia5NUGTTU3QM1WaztXmp7WFrCdpatAOWqPg2RzA1a37nbB3CQUG1WoZta2rF0drmdku42Gy37WFSN+BmitCOrpBjqQEE6ktFJGnVMB51xmhTQ+FXXaIN1oEJsOpF3XSYD1yCddSeogiJqL1sna9RwBNUpwCMj6wdG5os0doTw76mfF+uLQ/qGdm5dDddB5ZAavyoG08KRqg3UDSN8GxtWMCQ3agUNRgNDRhv5Xg7cNS/fDVwIXrUAf6FaE

jfXv5AUaqNNG5IHRoY05xAQycRKbFvY2cbiRPGvjZ9kE2sr8GImn7vgGs1nN9a0m2MrJqtXi6lNAkeQMZtM3fwwIOmmvvpus1GbXYzmszRugs1WbjdlaWzfZuNiObN9Lm59fWk83eaL9ZukyJOoU0BaU4QWoVVmrC2zyFVbAKLTFpf1xbQ9t6ztOhmS0txUt6WzLS6Ry2pq+gD4ArRXDQQlbME2CXBJVoV01bPwdWhrWoCoihwWtbWnEB1q63Age

tG8vrYBEG2oBhtJWmuGNu6mTa+g02ypZ9OqU/SVWdS+BbgFjBNKNJKUUGYxUlnyC+h+gmTJa0kBwBlwxAEYFJB2BIzLK2saRqjNUpiUrSLEozGMvMHyU86corRswsWXBsOup1LYCplWUxsek0IHgAzIol+CpUdjNmbRObpcz4xjExMQWxYlsS5J6YuRd8O95JDOgNbdpGkIbZ4wc6awGkY8o0XPKu2sycYLDT6zqyaxzSvGkiNkkyLx2XHRSYPMN

lFNLFY81oXwYrSCH1kbS+opUGqD6B6grQGAGaQnxR1dBY1T2ee01BaHei8IGI7NXIXZ098mQuSspWTD5j8KjCqObhMLkkz7BpwVmJ4isMm8zhGyjOeGO2VOGHKAi4IbGNALoci5zEotucteIBHhZQRkjut2lnLAQE9c2I03NBEglwRxwbKlQoklpMhD3yzI73L+Wa4WxQ8wozcqsUiEJ5uYS0uQTzIGwi1WQLOGrG/DVApIuLYqVp1CUQNGREtSJ

fD1lqxK6pm2hqXuN9TNTUluJZ+bg2BNfZ0wYJ4lRCeNiAhoTX4WE/CY+mhdQcNSng01Xbw+xyjmfFBWDMqNB1NAUAZYKQFhD0BBePA0IzHTuwbx9DJC3gJvn9mpg+oNiKEvFV6iyz8ZeJ4w1Mfg4352FVMk4aRO4W3VNl2x7OZsfg7Gmc2ux/9BIp8OLc/DlyyuacZzGxU8YuwTYNaJuPUd7ja9erttFWBQjPlUkjI/WOMV9zcjAK/I0CuNmjzQV

mfCeYgMpMAhfVu4BYOoCzjVBRi9wJQjIGiJKF0QTYBE4LUXF0jj5y25keifga1TH0187kbfKSUwsUlB2m5USbNzxnCdiZ9mqgBTPCrAQ6ZsYsnEiLZnFpkRPM3AA4OMm683ByLrAtbyiDcAMiDk8BJEOZQeTIKCfGVDc3VAKAtrd2QMvGFGCHyIy9MrofQmjRPs6jfGZr3l70pdqmppZfrxWUcLXBwY8xoaZWNbK6J6xm4SuK2PCKLTCYvY94YOO

4cjjoNG5dctI6rJ0yYxGYcHyeVemEjyYHsL6iY6vHXu2s5EX4dMUYkCmFi/48UYfq61SSNeyvYgLjing2+KAlLJgD9CTNk190wgTM1H6oAAAfGBtkobBKSgQCfEICFbYDNyA5lQrS17OZnkglJYELKUBBBBwKy8r9FjwfA4ZqSwZDNGhuX6HT2B9Azft+DT2BAeWXZyuGJzOBqc6N2zNS5FJf2irF+levSy50MuBKgqQDD5kiav6rjmRq2jE+tri

XVmEltZ3bZ/0bOEmjthFrPXuBIst8yLFFjvlRZos3M6LWUncoxepKsX2L4pLizxZ0tN8BL0RISxmeTiiXOSElqS//Nktfp5LcJoMmrBUvLhTLDLF/YXu0srNrLBl5MGhpMuckD+6lo/pWgsv1XdLagYVTZeatjn+BTJyc4z14OznqgC5rnil1QViGIZVR51pIjNLVBySOwXAGaSpVIyuuKQuqOodR5ISOj2hu4MQvmBRYLBBhz6dcZ/Y3m/2rC3Y

TsGwDJBcAU4R8zTN8wJBoQ+wpObwoOWW9nDt7Vw13XzmiLbzJy+brAViF2mhZbOa5WLNSGVZnTyEt01HwblttFZ3p+WCAm1DvYd6aRt49JI+O/LUSYZsxThcaFFGYzi7Pg3SCms9C0FEhtQckCkg+wjAfwKgLuctFezSpUpyAD802Byn+kn2UlC+yypdgLkx1SOV9LBwmG7BuwhIJoCyqaBiiupkiYsfWWvmgqmctY/wr2WCKQh2tkRZafEUvDJF

pc6RWmPtNgXHTSi2elCMuMlD1FtxzRd6e1BZUcUCyXG5JNrFscQzXxvJoCtwv1V8LmkiQBFsAO5xa+4CSuBer+DCB4i5DShrNr3Qadvm35roBEvojlmixm4rE22RxPbb1T9ZrHgSenrNndaYdqLWnGjshBY7jGH+n/X2sQKqlUCx2iyei7kVWi/46itbJBkzXuT9NiCXrWUCngfYuYfAMoH0AEKJTHRnmxAB+ako5TGYbQKsC7DaUQ52dQ7mqcmO

3W/RbgnUy+h65rKXzg3LWx+Z1vt19ljhnY/+atMm2bTkN7I5bcCPZibbRyAaKsAeV3GCCTt+IwhFGK0K32ZwF42d3SMIifbiffudhYe5tiKbmaUBxPNQgFpMz4OgVaEGFUMgwQ0QY2DXB6mFx7I0ZZQP4H6UadglRZ1OwyPTuonM764tbQ4Q2152b5uJtBvtpW5tTtauDRB1JGQd8rUHQqp2Jg45I4OK0eDgSAQ6IdDX3xI16BW3Z/FhRagtNwTK

0oHvtL0AUkZcD7FwCC8xgrQc0RzcQkMIDzvRWHP7IGjK9plF5mYtvZ2FuD9GRElWynL64GmT7qxs+yad1s/nfr7hguZEP2MpjgLINVhwouI5OmpZvEnrL1h6OO3PTwkrthcl9NjE/UKFkB/jaDM6zMLkDn4wUeBXRm4HKTrPugFJIVoOAFYNOHeUtLWkny9pICMoHtCtgoyHsHrMuBH5ooQrBcSeLRetwHklSayX4PoDitSlnJKoOO6gH0Bkh/AG

VyUoyUr3g7F+gIOvdFKI3N76gNGtvWaUo3Ub69V071f6UAorNWShAZnRkEth77TdoB0kquGUAPgKwqZicL9wDh1rHYJ4QIJZBgArNVQAIXIA6REecQk7HRpy+VlLORK3LFZzE1WexOMPttvllh572PHtSgrRTkp+AjKcPkbSdpPMjU8sjeRHYDTkYE08BAtP0NbTpgB06YBdOjQPTgwP062a/Ak1dd0Z+yQ4gTP5AIV9PXuD5WzP5nhGxvcRuWet

7uX6zzvU33/IBk9nZsQ58EGOd6bTnYwF0hc6udsAbn9yO50/Eedhk+tbzvxArgfBsBvnL4ghJAqket2pz41lnjua7scNkFS58GXbMWsyYRglrZcJ2H0BSRmAqibjKob0F7WAGBj029Kc2DHmsU51qaPnR4CJUNTO9hzPYOwApgtgxAd16B2pk34zKp1ewz9avtuOXDl9rOX+c8MAXTlZtw4wE5hew3khEvCWVVluX2pZkWNwSc3IeOXHJcCwpJ3C

NAfoWsjJijJwbMjMjy7klNko7Oc5C02VzlQRtJIDYCxhqggvbwX82kac32j3NzGZvQFvrAyUb7K0gsk2BvsKa4xqWzHL1s34FkMsb6wfcTf6mljGthui47cOfnWZtwrNwbZzdPDb7xc315AF8OP3obAhcC+cbxg/a/sQItrHBZideoVZothvak2SdoXwHuskm1A9bF8ce36aPtwRYyinhCAzgKSGbCHC7gZVzgTfHSAcj36E7+1ucYiZTvLiKHMj

OHjQ/ct0PPL4Lms7ids7F3/LpdwK6h/Q+Yf4oOH08Hh9hAEeiPDdvV9RgNcTnpHxr1k4wkaAKPhDfd0Q7UQUEOQ60TCQOfQFHN6O2jJXGe4u4ZiL31gu0MaB2G1BQljqYx+VlY9jn+ido5dex5wscfnvnH7569+fbvd63zT9vEGz48At+PBZHE5+4ourmz1lK2lUsrBbiPwWbOx1K0qG5yrR8vbrb6D+k9g+ZPu37Y3J2Ct1qql9Ae69B5brZYKa

XwLgIyJ+DfjQHWgocASHZf3lUiIe/zmHiiagZlmaPILjy7nf2tWcmH+J1j2zjLsZQsvOXoBOOp/BZrCvb4UHcZFK9SRstFX2UFV6bucGW7EXMa5J/eR1oZPFqK18O4kCC8KAZUGCGPe2sS89zXNwx5ezJI2ITHCyPfAvSvPBu5RpwDYAstvOmG45hEymSe71Nq3j7jM9N3rZzluffzHno2/3Rff32y5UNvzycZfuBf/h0XlJrkLRvB89ug0VMMzD

WFxfULmfNt58eJv/LSb0DhD2l6+UNetJqEVK4WRgBdlhilkv7d+HbSdgK+ihWtB/ZHGUazSTfaoKhEtyxXagfqhpm7HTKoBiAZUPp+cwMwjPOQluXZi6ThONATSKWNOpSUX7aIWwUdxoGWhX6IJcwhmtALSUnh+FAIXPukCmevAtb68d4BMjuWqCYA9YsAQEDAGApZwc49diCKpqP0aaWdPSOQI0zGD6BmAje5gLAnkxkk/fEFe/eepCDB7l1X4D

yaMTGCRq/9tu64DOofBcCK+XmmRKswzgAhstxS5OJ7t93HqCDroMMLK+QSoHittcDA+Vqm93i6QZpPfnfvQjfAVpPAUP1AlQDMA8ArsBg1X8aCrNcA9ADjTyz0C0gcwYYZlqnpOaMk5nYGhvU3pI3ka1nHer7Igm010gwNfAWg1JDA3cQH9daMDQkBJekBGSPwcwG7tdKfkvwWS5OFMyq+kfHL5HxbZ/dPmuXqptD+Wl5bR4+WuvgT9JXC+HJ+Vc

nyvBKfHbWp8mVIwDp86QBnxHFmfbvkUI2fDny5988E/1QBefVZgF9k4YX1F96YSyX0BJfH2Gl9NyWX3l9leMYCV99wHECrt1fJ1TxZtfCtB4BdfaWgN9OfPcBN9JAM328gLfPSGt9bfGAHt9HfDv3IYbYO/U99fVZUm1A/fAPyD9lSUPxwczNCP0vVggKUlj9tQBPzv0k/Qh0pgX9dP14os/LNVz8vFF8iF9C/eImL8qYMv3LhUESvwwQytHBGgM

6/Bv3lIm/UIH8k2/B8A78u/UMl78MEfvwaZB/YfyDJf5cf04BJ/TqWn88NOf0WdF/VZwFdV/OOHX9N/RvQG0d/Pf2j0D/I/xitOnJ2CPhLYTdRvJr/PP0twfyOb31dm7Q1yW9lRE13IpBedbxaU/aZRwWthKSRHjB8AOAD+AZEP4CMBVEadzFNbXQwRO8DPEwVGJ/ZcTjVMWJaW2e9ZbNwWIAFbLegWNdhZNzsNRTS9yc8gbFzxBEOZTx2BtgfMG

2iEIbcHw/dIfGG2ttmkUt3FlwjW1FWRCheEFBgondG1icSUBYV2hjqVI3i88nbHyJtT6b4y7dA7ATmQ8VvXAETZzXKQXvotvdAEUxaQVOGUBlgXRxaNxTTQ2zp0UNqHuBRgqEj3w+sDMFxResN21u8NqKwQmMnvCNyBAY2ZYBNEesK4URxPvLhQc8fvbN2olTTFmXc8sxbxyYlvPM5X8c/GY4K/dTgm5VCYk4XYAdtAPcL2A8+QAlGOpvsRJwDNv

bIxQgdkvX4PJs8LAEOE50AGANp8exFBBPgCzL3Dq9wlKhylpJ4C+Va8wXBh0Y8C7Zj35E//WF3YczcNUOZUBpTUOBDguN8ToxFvJUWEE4FWc3e8poT2k1FFHBoLmsbXfEQnwHICtD+AhAKSHZt4Qork08DrFWjxC57WrBKEZKLUA+wusUlEDkFke4DD4t7IkOsctoaz22sqQ1WxpD1bRz2ZCWZf7w8dfvIHxvtjbUHyAtfPY4xODofPkKC9YaWWB

RsPTB4ND4HUVYGhIIPFtw+DEvbIywsUvP4LUl0vWMxbN31PwM/B6/KNU5AxXbUOMJdQwF2odolWj0/8GPby069klFjytDevd7lnDVmBcM3Blwhk2GsxPI12W927MKAiR2eLoVe4uTeT34YmgiAHqBNCcklPBDgOtHF5Z3fRyTAOwEwTDccZRDnpg06X1Ajl1halFTBHvcN3zDliN7wWD7PMsLpCH3BkPcczTQHxZDPPNkPzcDg82wuVP3RITOMeJ

JFFTB3sXbXuCkfJWTkpZkDsFi85cd4Kg9ZQmDzx84PX42yde3KcOsVdaJRC/Q0AAXwwD7SYX0IARSCtH0B84RwC0QwwAgBXC/nJ/z04X/DO0qBgXbO0rNkeU0N3DIXX/xhcjwiQAEiOIISOTh+fUSLKhxIjgEkjpIoVn3VOAeSMvDJHa8MqCPQmcxZ4rhKKAAknwzk029GgoOjJBSACRAy0J8Q4GX5lgP4AkQ5KMYQCj/YaexVpZ7NqHdNejUxCM

MLralFBhJg4kJvxZgu9l6CERAyhLDUI77wcN6QgIWUZAbKiVwjdg600bDy5UC389gnUWXOChKHgEuDviXiV2g9gaJ0bluokglicxiKZXR9mIzH11ZPg321x8fggO0VCg7ZUKVAk1DiGMVq2QoBCMwAFaFKAxgatkCowAZaJCNUokIw2iQjU0CeA8OQVSgAYKQg29A/YBaKUUUKKAAsicQeBHLYo4e6PG1RhauVujTwUgF+AKAZSFB0nonEE+jvo3

6JBQYoqMNkd28ABk8ju7OEnBCIAZYFQh6gckmYBNALCg9dWjIZRwgZce9mRDfQQmTAj0JD7F2AbvGZU+kDSBMMyjEItxByj5g16yPsBudCNcc/vRkK2CawqqLrCQfXxw5Cmw+qKh8AvNsLip4QQ91rcv7PITpgTkfYEQsuw0oRYisfEcI7d5QqaJgclQ3iMBMzcZMEABK4EN8FI0qTq8VI/UOsJmvDSNBctI9r1f4mpfcMtD9I9j0qANYrWMcjXQ

ioPdC/pT0JZ5j3H0K8i/Q2TyUdAwhQQCiJEHikaBmAGREkA/gZYEij43PoMYQvo2KLEptoTGRfY0JLFDxi7vXCgyi93aY12ExgBYVhAFbFCOfN6YkqIwiyo8hQqjmZBiSfd6wzmILdOQz4W5DSI40Dhs/7NqMrdfQLUDqxhY521iccbdMARAA0QcIMU4+YMzlCOI8cOmj/glWJbx5oqoSWjq2VaLmB1ozaPnidozoGTjOgA6M6AjojePHBXA86Oz

NiAK6IpB3oskDuiXkR6KPFno0+NDgbo4+MBj/YYGP+jiAW+J+iQgEGOjiwY/6TChiHCQWhiwQvyJBR9ASQBkQ2AW1jKhUVKe1jiDEM7yDdTrexj6x+oE4ATDGFL7HmUEIyzzcEs4zsFzjaYs9zQjC4xmMwiL7AH22Dr7XN2fcq4wiMLcuQ5sJ5DWwiCzxgMqPrHA8EfBWVoi16Y7jWBYaZtwHju5Qm3Gjvg/2wjMJwkFQniQ7dAC4EzmYTSuZtY0

L1P5izaHj1jGvNE0Nj2RTSO3Edw7/z3EoXBs0PDrYwyI34JEqfSkT7YvCkdivxac3qVGEXkEfDPYjbzk9lzP+LCgvoiRFzBFMWECgAtgH2F6pIolQxnc9BUGLii44j1j6x/ZVeMuArBNOJutKY5zG0p7bIsIKiHHfOPIk03UqMrC5qUuMOUPDCuI5j2Q6uO5irQktxCMdrGYGbi8xXAmxsO43+1XwEQF0WGg3gkaK1k5Y0MxHiFQpWJmiREz4Cnj

FokI2Xj1o+eNWjF4meJWjV4heMOjjo7eO+Bd4wsAPjXIKGluiXos+JuUL4h6Kvij4meCfj748+IBi34jZKjjvoykAsT3kQgCHcHErTBgAjAYakOAOAM1zRiEQowROBF3UCIGICcQOQ2Ac6NXhgjiEMmIs993GNhiTdKPOPOhaQvBOc8M3Vz2rCUk8uJ5k77WqIh9qE+uNfs8YAlARAxoCpIi9gcbaG2AuoupMg9ZYtiKS9mkxWMJ9YHYn0ocCeT7

mz0wNPPRg1trB/zm1dY9cINDbCFrzo82vF/kSUtEg8KtiAA97nJS9wcDSpTlwMDW2t5vccwYxRrKoMBDbWOoJkEAwhTwkM/Y7ACVV6AJRHJJbWOkEii8oo738TY4pKOwgdoEJNBhGFCJJ9EM4mYLcxjqAFI6InHBmJBSmYkuPvd8EtmNITK4nJIoSa42RR5iWwvmMbjikhG1CdV8AlEBFUU0UIjAVFJ9ieDpQhLzxTRwzt0JSVJRD0NxZosoE6T6

wQZP2i+k9eNKAtonpLABhk/pNGSt4gcB3iDARrSmSONQ+L5C5ky+LejFknEHmSVkytJvjtkl+Ifj1kltPbw34/ZL4NhwaxOBlYYxODpBmAM0mUBDgRBQ08MY+5N6JIRUYJeTs6VXjM97vFBOvMTUrUxjZXMQmAtTsEr7wLjkkouNSSsIpkJwiK2VkK8MCIt91tMjguFK4kyI3MT94Zce4GojhQn+zRTNQb7C+wMqBmGAchw1iJ+U+Em7kmjBEseM

nCSU/JwgBpRVAEAAkwhAMzmXvXv8HLOlKUj5EhlINjNw5lO3DtIjRN0iLYw8SbNdE9AHAyoM+vRgyxyUoJE9yg5yKdjzEvg3wBpUvVjsTrXX2KcToQZTFIBDgSQFPAJ8SKMO9pGbVP3NcUTGR+1E430ENT86Y1OJlV0+wT+SbPD70KjEk9OU1sr3dYNBTNg5DmITDbdmL2CS5N1LyTi3XkJ9SIwEpNnpq3N9iliaI5hLLEUwJEMDk9FfuJAyxo4e

IAzzFIDOESQMlNIKA00teIzSBk7pNni80zNLABN4rNPGSzoktIuj948tJmSQmKtOWSa03EiWTXo6+LWTm0v6M2TH45LNfi9kwEMnte0nu1hjFMYgEUxSAW1lqBagDoXHS4owtgEzIE/GIAJZ0t5IXTSYpdK2FIktBMhApMuJMPscE4qN3THU/dMITwUvdMhTjlGqJ886o/JN5C6ElYEypgIsL2fSQ0rGSSNtgdMCljO5QMzAdo0+WIJTAM1pPHiQ

MuM15Td+SlMb189GlPgzz+RDIqlr+JRNQyjY40JNi2Un/2wyWpAK25SJAQngpSBUoVIkcHYijLMTqgsKC4Acsy13ozYYv2JhliAQ4FtVcwZQAkQMqaKM7TNDfjKMcRghXiixQko1LzDWs1lAesnrF61s8nzQFNwSes21IISAbB1JJynUrJM0zX3ViQvSLbEiOvSG45qKbi/UiIxWBELWezMzUbEPh7g/UTsNZhsU79NxTf0hzIESnMnbOAy1stzM

NQPM3pNnj/M7NN8y1o/NI3ixkotImTQsveOmTEsk+JiyH4+tNiyosptKBj202tLSyTclLN2SY4u8Pbw2AY5J9iJDM0gQB9gTACkgLAcBL4yjrMzCEz/WEhEYjMhEmJrwvkzHJ+T7BHHOetKQ+JLs85M5YwUy1gyqL6ywU7CLUzH3KFIbDRs2FM9SaEvmMmyeobUGOBTMp9N6iecrsjGgsqP9xWy8bH9N4TRc5PjjTh5InzWyJ5GZwb1SyL7AAgPY

aLTn8IoX5x1iLs5ywa9qPG7JUTjYtRIwz8o9lL0jBRG0My92XVvP5B2892CzgN/LUG+yTE37NqVAQ9TxBDAJYHO9i5Uwez9ihAckhbVTwIwHaDYciOKKSO0zLL4yTrRML6Rqsp5PsZ0c0TJDzTUyEGjdtgON0tTIObrKNMj03ZUzciE1mOPS8I09PBtz0h+3py64xnKajCkiXlajWcq4JdNNgLKkici8nsJmBkwMaC1BZ7VbJlCRc9iMcyybCXJc

ypciLNTSfMlaOVyFcpeKVyvMgtKCz1ckLPjIws7XNWTdchLNSyDcnXLbTLcuLK2SLcjLOtzwYxhHwUgc3+IdzB7P2FQgeAXMDrQg4j3JO9tQTGRrdUc8CL6hN8c8w+Se4JrOeB04iTN2Ev82NyvziwhJMJz/8t8wrCgCpPMPSU82sOdTsks9NpzoC4iNgKiOH3lvTILLUECTZs4vJbkRjJ9nhAv07hPeMh44grFzSColOVi9sgIj5UPYRIK38Ug3

f2kT5tORMuyXLa7MNCP/J/nHyOvLDKLtLY6fJwZ4i6TkSKdNJIO39Ui4xKltmTCTxtyo42jJfD7E6QpUd3kJxJ2AyoGRCUQN1EYEkBYcnxMjiOi2/JO8acvVJRyas4TPxkxMlhV3tIQBACtJ5DFYPMLo8ywp3SAChwuLj0JdJIeFMktPPISoCw4JgKr0zwuCMbkgzOQL2ou4DdsX2YNNFjRgTfH6RDuDuSrzhcmvMiK687bJiK2k1zMoL3M6gvTT

5c7zM6Ac05wD8zNotXNVhi0tgq1yIsnXN4KeC6tL4L0s1tNRKb80Qo/j28FIh3zvInmFhjYwSQAoAxgakwQB344YrnctPHbUeTebW0R9zSpLQqgiGsoPP0LrrFdLvN7BRYthBli3/LTlY81YJsKrefrOTzQCobNBsRsrmLGzdM2hJ/cVgVmB7j7ivqL/svsGxC1AoSSvJljRoxpL9svi8XJ+LdspvLNw/Na1VtV7VPzmHU4Mg+T7zZE8hyW0rsjc

JyKtwvItNjJ8p7JLsevPDIgBjSinVNKxWC0rXy6i8VNciDk1sGaLfItovfCtEf2McgjAfABhB6gWHM1S1DF1g0MjBJ/NpKuyGkuSiACHrBEyrBPGVQTQ83YQ8QvEFYqjyCc3zFCRE5B8OJylMu1OAKBs3rLFKvPFwvfcTirPPhSzghAouCriluPKxLjd9MVKS8/GBOBakn7EjThwjbKaSSCgn3jTG8+ERDKhAe3IPz2i4MnJIxgW1laBySS2XKyx

KKSmlN5YAN1xj72TG02BA5S40DkPRXQq2o6eQwo5LdhWx29DuuU923SkkzYtALbCtO3sLRSo5XFLoUjPMvSOyuAph97US402BH04sRFCHihcRlxA5H7VeLNShpKnKdSuoT1K5y4lMNLy7WoGXBoMZwFDD7VStCm8PVKSE5Bx0RTGIxSMFdDXQn1H8B9LnAKtDfAc4StCgMpvRLTrRLSmr2TsbSij3q9SUqqSvQjQllJNCXS2s0LsP+aFxKKkWM3D

NJsK3CvwqaSCtCIrLNUity4KKhyCXQqKijBMg6KhiplV6AliogMe0UjL4EnIsVPE9bwsQveQ4Q7+ItdQHFooYyJDKMuqAHIQgAch1KutE4yxoFGRTL9rfTExlfC+ktDc8y3CmgS2S8TPvL0EnSmkyE3akLcFTKcyiGKBSwAqFKyckAohTfylssgLXC44vcLTioJ3QJ9M10kMz/hcYHhAhQyCrmzoK9emzo5Kf3k9t6kwxSIL8Umcvg90K2IrWyQy

8kqkBfQvtJOT0AYrKUQ/gSQEUxAQbjL0FKSuMN1TIYfmw0LZUWWHxQEnPYAMw3lAMEltbylrKLL0Ek6jOot00sKsK48wUv+svylmPSr9i4bP/LJSzPPGyZS8iJhoZcTe38KsCszC24DMdMuliGqweLScY0hWO+K2q34swrdYUwO0koycCHCBpEnoy+YeKvUMUSHSplNuyhK+7K21laMSsgA/LHRNez0AEvFd1gax2FBqcS50NE8zKm8IlTGi95GG

BJCvJ3srYYsqAoBCSkYDgAtgGbWjDBlOKKmqykBe1mqACCZQRBxoRUzOBj8XaFzDCyj/NZR97GKtkz1it8usLkqo6so8TqwbIyr8IrKrbLcqoCrOKb0xG26IhoGXEJwucutxeVZkAz1CqCCqNKarvqrbLQqG8jCvhEJ5TK0WkUAlZnOYN3SyUUImSMkA4rSHNcPtLGUveQf47ssfJEq9woopwyXsmfIyg7a0CAdqeWJ2rJQXa3NWZJjKl0PXyial

yOdi3I8iiZqbK0EMprwylcvfDHVM0jrRcwfQB2A2GXcqtERlLQ0CqMqFICJiA8tU2q5yYu8pe8Hy5CN2qiojYulqtixPOOrVMn8rOq/y9PMurAK66pzzZSzMoyp0yIcpbk1S46kO5QiuzO1KJoqItnKra9qptrjte9UIwn1C8ldUqNAbRT1OpDjVFEuNTmknFnxAZy99CpNOGyA21FVxHF1wWUgEi/AZdUUItwWkCfE7AcIBdJagXnVwBnAd+BQC

f6VeSXyLdYBB4AFAROFJRideDEbRm0VtHbRNwcdDrh+/LLTEDvfWUiZ1/VK+sbUi+cX3J4m+eMHKsM0Tv0vBsANV24teLWdRl9BURrQfA9LftSjgVmKcUj8r1InSP0Y/EhASAHwFhqUDjYdSAZ806CAKb4lEfWAug+gZdWYBWdbqWecrIBYA/qvdS2GM0dwRNU1d4iChiPhi4FtQ8DnfbAAd8Q9QpzrsdXEwK0QwyX+C+caSHEDYAoyASLYMQINI

vpTvaiQHUiR8/2pbJ1EifMezg657LY8MaiADvUI9IjF3rtNcdF/U6NY+vrsR9c+q/rL6wNQEjwEW+ozV76xQkfq4KFoDDgHwN+sKspxGJp/q/6gBv9gP4a3GAbagUBry9IG+Uxgb60OBqQwUMJBpt1UGujVZ1ndV8ivr0GhDTwa8AxlxdIiGpS3RBSGq8Aoa0rb0GobiA2hrUB6Gvq2y1/4CCB5ZeGqP2M1OGjYB4ag9NhuMDBGmn1Q0XSURrJB1

1HpAfApGr3xkaaDeRvApFG98iP0VG95wVwhfEQG6ltGp31zg9G4ChdJepCxpkjpMMxvz4LG2kmIBrG7Mim17G2oq4NzKkmssrcAIwDDKQcvqpGLYcgXk5AeAH2EwB6ACRH6R4c0Yvnc32fyp+0jyhcWCr0o9/KMK4qpYvexeS61OBS6y0nIHyRSuqBbAhVPHNTzzqoetySpSq5T0zmc31LAlrinqG6NOczAtYSu2HFFGJYaf1EFywigmwiLmqlet

aq16/6vhFpck0Fly544EsOj6ClaMThaCyEsLToSjXNhKy066M4LESs3KNbZk43LvjTcwQvNzzWy3JGLMSl2LeRNAbUGXK3woOjGgJ8VoEIAq0MavRi4o/YGxaWYUYN2BXksPkDzXIOSnWr2SluuJbuS0lvbqY8i9yG5485mU/K5avutOqT0vN2Vq6c1WtHrGokCusQBoXrAgrv7AIviYSUfYATiEKj6p4TJW82paquIqMx4i4i3WjM1OtP1WmZTI

a5i4aHwRhpCg5m1ZpD1zmPjQ9g/gPpzRBfgV0AdJ7AKIGApmAD2pLJ0i20oUSh8x0rQznSh7M0Sp8w7T8bW2rrQ7b/wEUm7bpmlBFmanxVhsHbYQYdtQBR21AHHa2ASdrsA11WdsTrCaxVlBbgy+BUdbmjLOt3y7K3OpdaQUKMuhB9AbAA4BBeckkwBGgVFsSqjvL1wCTQk6AnvyZKP4nxlQqimKxytKUNxGBAsX/IhAEAGEDsNZxU+wpye69Nnl

qmyxWogL9go4qIiQLXNoKqOW6Kl7LQmCtpxQMCiqtLbvTRrkrE/QfcpEQ3irUuQrl63UuiK/qg0oXLP2lMGdajWdop+iZEYgGUAdgcymUL53Pwt9kMsGaqmKIwdELfYftWWDPKRjKWJ3cI28Kqja2s9+yYQyWoFNrKE8lNt4rvy9NvALM26juyraOotzZabq7wt4kbETFOnrwRSEUGgvsfAoE6kKs2s2z62rJ0bakPdpK7F0AVXQdgg1F2DzIXna

yFshe8oWn7zKPV/2yK4a1xoRqA6jdvNCt23DL8b4u5+APB1IYBVS7hPEyp+yU6yjP+yJAR1qvyoY2ypzroWiMqDpVUtEDrRkgc7BU6qStTulMIRZMLmotQeICGN1SrsAliho/EM+lvkkWtLpCwqzqJz3ylJLs7oxTNm7rmypWpc6VaujulKx626p209gF4L87vTPmouRq3Ccurza28LulaG2hNJKYYuknzezpaLIEcBDke/UAE/4E9ty7qvT2sy7

7O7Lthrfa4FlHz3G/IrNj3CN0u68fCT0r18mAD7qsA+gb7vMbe26OADKQW4mo/bRBR1u2wKa58P/aZO98InwKAGRGhBNAIwEtZV2cuq5sg0s7yrq5TOBOgtTPUNr5ArrdDs2rIQR8pW79qpKu7qNu3Yq8cnOshNdSaOyhNri8qrMSO6vO30DkoF6dFD1qRYpUqUoyUVHyM8bu94ru7pyh7si6nuvEiTTSUyoAhUK0ePXLQq0J1U9hBhFdDrRl+T1

UPap5LBvabOGhIAT8dtZYH6ZjGw1XYa35MBvHUYEAuGD8HmvJRzNm2UPygEc4a5gNIz2vhqF9aCdSygyndQwPuBRmvFDzIxACcQfAsav3VBrLcNRpFIkgJBCsCitEbWr97A1uDd9F1QCGxAHwdwMeagyZSH6aGmNUjNp+IFNRDJSAEUj6g8yerXGbPnJgyrs9LIVTBB4iRQIWaOAe9mV1P6F+HUg7NF2Cr7F1eXUrU70TdQvVyXBfTb0BrCYFzUa

QagGM1UAUEEudVmCu1zBG9ILU792tQ/qVdwKPoAjQfgGABFIPsPMk5pLoFdXjJ/SQ5E3UGmZ3tZ0HGoHuXaVtd/ydL6HQOsKLxK7RK5Sw6k3p6lze6DEt7lwa3tQhbe+3pT0LcX/pwbOdd3vlgve6EDyJCdEUj968vPOCD7ZAh8FD7FpcPqlIoEaPqnl5mtZvOaVmJPqzUe2vPzT6p5ICEz7GAbPqBq8+jR0nALmovpQNrAsvrsCsDRfpr63++vo

79rwC2EbgW+y6Db6CGcqxCAu+jgB76gIPvuJA6G0bSH6pmkfpnhA9c9vYap+1cBrVVIQ8Hn6wwCQeX7FddwDX6X47Pqk0t+pqx36RRffqP1r+4/oaZT+8/pxBL+sg2v6a1O/qFgH+p/o4GFcEQDf7i1ZHq/7QIH/raa/+4FrdC/slb0dbEq1ruzqiejrrzr/IpxJgQyoSSK2BlAByFRbvWxxIxaqSjdK6McW0YMmKU4gluFqiWz/Jjcf8uNslr5M

gXo/KUq6loc7KgOluUgRe6qIuqWWq6sO6821AEKqkCrlr7LZKE4E5RzuhI0Dk/Qf7HqqcUwTrC7dekTtXq/jOVtAcFWnpJzTNW1VqVaNWxgtVztWlbBhLS0y6PhLDW5EqRK9czgv4KYXKOBeGKhu1vTrKgR1uVsf2vEptlOu/+JGAhAEYHoBiAOkC/jfEn1omEEO4wgDbOa9sDxQUwd0UQT86cNujkNqxbucwTCtofxy3rP/M7qDqmWo2MD08jpI

6duqjq0yJe91P8M1a/Ku4k5eoYkJRi2nqKer8YUYn9BxbMVsXqhO/hO2GZW3YfE74HM3F3a/VNll59aqa5koDVfHlkOBnAC8Fk4QQWPon7aTdVx5Y34G/tZp7+lyXnbH/biuf9kMkiGUS7jHO2ErCuqFmK7Q60opbbt9Ntt7UvwCUfigpRlXyrs5RhUYrBJVAdvYbVRl5xWYNRmtRkhtRmABfbyM+rtSHSax1ryjMh39va798gDqhlqTEKNXBWbC

RAzBvKgwTRkubJty6MkchEYjBX8qwTQ7m66YMhBw8hlvFqLCkygghlgPzBtTKW7YtSrGy8kco7nOqkdc7Jej1Po7ziqEbuBiqyIxFtZYRYb/tjgWhSZgNS6tvCKvq+7v5HHu+ctAcDkx1pWDox/4bptAR97mUBz8qiEvABuuML6x/K7ShmoUwmxAWqLyrOPlLRjNaoxHI2ksdZR5bRW1+GKxtYqtTrOtbr3She8nPrGwC4YeZbtM1lodNPOzWvxh

fC0JOV7O4r1CJhcUVey16Nhj4qlaZx/XrnG8nOMysaoyMzVsaySoFpIcyPfUZLMnGo0eHyTR1RMh6wB5GotCQ63xugG3uv5tQnt9dCfYNkh0xM3yIxwOSha4xknqDpmAMYEwAyocknJJOQeczp753PcZzGOarTqlhleWuVGILkXAKZKha5dNM6bxpbpWoOsl8r2rCRrofW6eh1NpjEj0ikdbGac/bvc7/x2XsAnY6v1AA8OOtkclivsUNzWGhcmC

Z16UKvI0trBRyXI3rdaG/2jsSADkgaYzBlXXQ8tVaRLIcoaw0aiVV2+GvQySJ1BktGKJ60YyhPJsqCPgFO42F8nNR7kGcBAphiY3yZHLEvQBHWsutxKbE+oJ1EYW0Oh2A60fAA4BReHcYYQ+sSuppzFeJ9jSlwSaCLSjiEFmFZKuerEbZQ26vEbpipaokcF6tJ+zrJHPxvSbF7Wy7NoO6POkyf9SJ646iV7+W8zPBEZcBmG0ohu/jsQrGq2Cbra9

e1L2trhR3WgCaH1IJv5VagRtHgHtNQ+pT7k4N8jKbwG77saA5VEq259rcR2oIhptB8FPBs/YVm2cEyChkxdl1AgHAoGfWn2ubcgOjV9VdmpAxMbPm+gAfBZG15x5ZwZsILPBSDclzomrIAbXy5NSCdxdJUIMEFGdPnWGSrR8+0UDYBQdF0kSnvJ5dXBnVmPyfAp0prVTPAfYSZi0AiAelofAfBmRCkgpvRKaFA95WlPOycJpDLwnBCYAbXbQB80b

f4Ypj0r8bjp7esHQTwVCHOnV0GDDCbNyTybumPYf3qt0T9J6c3IzSF6ajqe+fAE+mzwH6aFdMgBu0OQHwYGbACEgMGbUbUZ1UnRxbZ2GeOd4ZtV19HkZ52ZINEAQIcxn+tOgwvI8ZzcgJnSAImYfASZ6tA0dyZymf4skpjJtUaBB+mbSmApwgBZm2Zq9RzBlILmc/AzSHmb5nvocBTKCFvRiZyn7W74bGBNWQnp8ich+MZvyJEfg2SALtTpVTGYO

njIRz9zZCxqGA2PMexR8W1yFmKZbO6zcEyZMXifL8ozrNfLOhxNsOqSRnYo/GE88aZdTJptwumnjJiYamG+x0YChJAwcqpLarJ5mHmouEnkc2GnJ8MxcnuI6Lr+KFoqgtBL5c84eYLASzoBpKRki4Zfmrh3VpuHwsg1sbSZ4E1unp4shZNNaks4QrRKIFjEq6qFxkkuk7xDQewJn+PU8FOop5o7wmqfXeoYzL16eEbEmrSRkp0K2pnfHgj5JuYsj

ddhCeYpk+e9SfnniRr820mtu/uozaJprNo3mjJq2wAm5p9ekYT2Oo+YFa6YfpHQKs47kbWz7Mz4tQrRO2VqFGkJo0oznB5uIBZpNAFQAUAwDL8DhMfYTzXtU/YQwYXpZYXUYQyRZzIsHyz5cKby7Ip6WfNjvG90vh7SuuRaFbPsQ2iUWYgVRfUXNF7nx0X/QJKSx6UhpicsrHWuLkKngZf0JKm1x21wkRmAeoDrQKATAHJJ9AaoFTGkyz1x8rvXY

wjerEO+koLKiF73MJaIqyEHXT3MXDsLhKeqhYpbbO4afZk02hWoHrMqvbqmn2FhqIY7uy+GxmHlFHShgtmEoDyqqxJabvCc7J8VtScMLXafgn9p9evnHJOtnkCXcsmFsBA9GpRE0BjmeunQXAImCv3HNO5/PQkftIWwoVsw95KyWaUEzrIWSQ+wRhxtQF/hnm1JgaY0m3x4ac26hFbbpbGWF2pbYWqEukZl6Jh3PN4BHUJKNAnKkspFGhVp3rAXr

RFper5GJFnYZvnE0l7uN6VwTUfqA2AKb1VJSAEMBrR68ImcPB9wdEHBqvarItB7BK8xaRqbOWWZsXKJ9AAZmaSeFZIYkV3cDgxUVirtdgMVntOwok6wMvfa062BfEF3Yn+NjHZUxuf6EtgWMHqBoQSQFhBAZQSapLE4e/OgJRJ9ZdvYv2TYF9ROwBenV6t3OSeazrxseYLDlJ6hcuXaFoadlqRpypYo7ql3brbHDJl5a7GNarhfGIjgFkcR9lpte

nuBMqLGKBXCCnaenGwVgUYhXnu5toyhOtSE3PBrxbGrjhaSaEF8AbfDlTjgcyROWsAnQoJWAZsV4xaa8CJv2vy7iJixZh6rFuHqwY/Gv1eNgA1oGuDWOAUNar5cwCNcKlyAEsC1CspsMd8XcphETGAysyZb3yeV9iZBQxgKSBH4dgWMEfiap4wnfZGehqbOsF6Ze2UpxidnumRLHHJbM6kIh8z6musmheI7Px98bSqql5hbXnWFnKs3mOF2abZy+

kZWSZghx3VHuTtQWbver1h0LrdWthj1dnGDpmRaOmf6eFVPAlEKPRbQbVEtCy1f6ZgEoaZAAuaLm0AAAHJ7nNXXCXZ+mwBCGsgB/v/WNIf9cRnvQFRdPUIgN2H/XidUMJRUzwQbUgxTwWMCm8stcryohYAKdT8R4ENADJWyum3FA3vwKpjgBG9C2kb1lwKvmOzj6pvjw31QQjfRBiNtQiBqRRarv99r6hJusCjQRvXfrPR3JsNmY1dDzHc/VJ3Gi

A7wQcXIaWN2ADQAqu7GfqAaNigydAoARvQjrUAbaU6l6XeIlPBaVl2GZd6gL6OuA6VxNV5o5ARvUtB72+Il1V84UOF42CARskn8w9d1VQhlwWoEaBS1jSCUQZVRB1EY1CWtAchChgjA1nSSM0nE3nAO8AD0zYb4HEhgh8kHJd1IHSXmIhfNB0RdiAZHQANgyYtS+69AY2jJAcwUIO/BhzP4BgAq7CwdVUHwICATJUe+JoggOAJAMP74oegyEBkp+

IhPBWAIiF+4IIPAFAhfoqFBKh8auNb1HaRJdtCmXGwiYh74lTDItHYe9GpJX/Gh9Z00n1l9YrQ3166c/Xv17md5mANoDYdgQNulciAMgCDZckoNk8Bg21R+DYghEN5DbAM71CtDQ3a0fLkw3sN66YU3QIW3SI3Q4EjbSn766rddg1Ftmho3eaOjYY3d+/AGY2CdAjZ+32Nv7c42j1eIm428axvUa2K/QTcUgP6nJpnFUZqLZGkJNrrWk2iIOzaV0

vtpTZoMVNtTb9VKDHIC02oiRaV029wfTbPAjNif118zN5QAs36SY2l43bNlvwc34EZzeXIIZx7ZpJYwTze83fNk8H83TwQLajVtmAjzC3p0CLZ/pot2LeNh4trFzvQSKK/tS34EYIAy2hVLLZy355IgCJnjYQrfRwStt/q/Bytyrajsgd1AC9m6thV2NgMd5rZdJWA2qna3OtjSB62Dffrasght0ZzkBvFiuYaK/FsYHVE65xcwbnW1qGSEBulRo

AhHlgNgAkRDudMe0RUyrmzSWkwWexTDcy/GWCSmh3JdZRsATQGIAgOb9sfGKy5zDhALKaEBpTF1spf1Xbl/WyNW115wo3W3O81fGHGli4qKrmOv3k9ZRoQ9YXE9gS4zOAp62zOBXeR/9L2mhEnJxAzYFv8T+HNRWGJ2BWgZQHrg/gCfEZWh9473nc+Oh/JVosF7MtGAII97HAbRierPHWsZA5dHn5io6jhAEQWNefLYq+NvLC6F2917qdJ+5eNXK

RgybqX+9mafeXx67FD9BrSCfddJAwSsQrboJi9ccnhO69YQnb1jLz696gJMit7AQCtGXBkGm1V7Q4MapsQwEGjtBUqRxFLTO0pIc7XwPkAaRM/tIaxbWhr+K+/nB63Gubc8bcTQnDRqoBuKcqB8uHA8QG8Dgg5LQiDmtFIP4G5DEQbKDxQmoOW0Wg9EOGD6tbfacetlck7RVptb/aE9hBfaKYAaUX6piAW1kHcxVuMNP3UUbjv9kP7eIBTAzgNuR

SNmS1yDequp5odZQK28jm1W551veTabl4Xp2CNMiUtGGR6gfYZHAJglBJRZ9jpagrVezUAWEftWCtP2TaycovnUD5yckXXJ8gvcnAAjdFzgp0FtE5BbYd/VX0aSPQPNLK0BIHXktyBQBvIgG6vtJJ/Ni1VjApnVl0QEGLSDXR24NACHqPLcddB9hzVFo50s2XHDXit69KDXI1282MjrQsNzUEMTON0TWktN+ufW6PF1QpxlVEVVoEMkLxBBF70tL

CJtPB5fIjJWPUASLfW3sN08Cp9HZ+0JP0ufX5AMqO/cr38BZxM7IXEE1viqAGBK3IqlmCVjHkW3+DqSqCtcj4jAKOijktA/0/VDPz9KKjqo4pIajz8jqPVjwqQ3RXVQY8A0W+do+P5OjhgWOOKWPo4GOWXIY+r1RjhZ0b0JjrZ1JJAQaY+aOcIOY++5iGSTQNplj6vpOOepdY+fWtjo/sY1qSRfn2PDjtjRxOf6M47LRLj2nxuOkEIcHuPnfR44T

xVD+2nqKLKutcdady7Q+5WQl7KHABRYd5DtxVIBCHyhoAZSCyA1I9IkmAGAeTl29yy/EdjYil1Nw/4RdHIHqA+gfQAZANVpCPZR2UQYBgY7TqAAdPMgcra/2Oh5Y09Ovom6B9PoUHw5/wgz4VFDPnTxeeGqEAbCAYh/SXmg9PU1YM/tPHTmM4BBySYrdwA5OIgHuI9tS6Fd0Uzr0+jPDVknMjOQzx06vgB6uVErP0zzIArQgj1GtLPHTgmYW09OS

aHrPvTts5eOZTE09TOozx0/Sg2Dks7TOezzICzJqydEvkVuz0M/K8rW5+JtbeM20/HPQzp+Kkg1DSsDHOhzzIDJ8TUK+DFADcL4AANaQaT3fQBjFRSxDR1kcd1wTzpcjW8+kUYhV5xgUaBxRN8JIxNOjAaxsnsuyoggIBAod4BSBvsWGhGAt2Oc+rPeQithxAPTzEBIASpeodpz4LvoFHNecE07gviAYQPK9cz4ICkkkLt6zqIyoEEEA7lAVEC/B

0CxvQouaUZ7AV9KjykGqdanJzHZIyLjGkouDET5Z37leOi/AvBzm6EzOEAJs+M2AmWkaAgAEBZLqJsgHC9WRXIvLdQuwWsoBPhDThU4zxGMPcVcj6XAEFIBYwE1Cj2ygDS6YBsLthrxgaEcC7sBbWaTGYAYEEqCwuT4Iy/O53ka/SkhrGmjL/PhiteG91msHiElJvIZ13aI9hvJ1s2nTo5wrxQHU6KsHGAJy5BBlYcC8PUpL7eX6Ancu0Hsu5OGL

JYaMKQsjqhJLuy5NOcwA3MMvcL3S9KFP5YgE6SrLu3HgR8r6S7+kwHTAFVIJXF2GEDx4WFn4QukS9zBrmkdU+yggAA==
```
%%
