iimarky1234/LoRa-Weather-Station/docs/Final Report/26FA_IA2104_G2_IOT102_Final_Report.pdf

# LoRa-Based Climate Monitoring System for Large-Scale Farms and Greenhouses

Nguyen Luong Gia Triet
FPT University - IA2014 - Group 2 trietn31@gmail.com
ORCID: 0009-0006-2792-0802

Duong Duc Quang
FPT University - IA2014 - Group 2 duongquang2208@gmail.com
ORCID: 0009-0003-5452-9815

Phan Tan Anh Khoi
FPT University - IA2014 - Group 2 pkhoi6261@gmail.com
ORCID: 0009-0008-5517-5410

Nguyen Thai Thinh
FPT University - IA2014 - Group 2 nguyenthaithinh13092007@gmail.com ORCID: 0009-0001-6356-5258

Abstract

Large agricultural areas are usually located far from residential zones, where Wi-Fi coverage is unavailable and cellular networks (3G/4G) are unstable or expensive, while indoor greenhouse climate parameters (air temperature, humidity, and light intensity) change quickly and are difficult to track by hand. LoRa technology offers multi-kilometer wireless range, very low power use, and no regular mobile data fees for each node. This paper presents the design, implementation, and three-day field test of a low-power LoRa-based climate monitoring system for large-scale farms and greenhouses using the ESP32 (ESP32-S3-N16R8) microcontroller and the MKE-M24 Ra-02SH (Ai-Thinker Ra-02, Semtech SX1278) LoRa radio module. The sensor node connects five environmental sensors—AM2301B (air temperature and relative humidity), BH1750 (ambient light), LTR390 (UV index), Grove Soil Moisture Sensor, and APM10 (fine dust PM1.0, PM2.5, and PM10)—along with an MKE-M09 RTC DS1307 for recording time and a 10,000 mAh Li-Po backup battery. A compact 26-byte binary protocol sends sensor data over LoRa (434.00 MHz, SF12, 15.6 kHz bandwidth, coding rate 4/5, and +20 dBm transmit power) to a central gateway with two permanent storage options (MicroSD card and 16 MB onboard flash backup), ThingSpeak cloud connection, and a local backup Progressive Web App (PWA) dashboard. Across a three-day test in a city environment (November 5–7, 2026), the system recorded 807 valid sensor data packets at a mean interval of 60.10 s with an average RSSI of −76.77 dBm and an average SNR of 9.05 dB, confirming stable data collection despite city buildings that limit current range to about 1 km.

Index Terms

Climate monitoring, ESP32-S3, greenhouse microclimate, Internet of Things (IoT), large-scale agriculture, LoRa, LoRaWAN, wireless sensor networks (WSN).

I. INTRODUCTION
Environmental and weather monitoring supports agricultural planning, crop management, and natural disaster prevention [1]– [3], and keeping air temperature, relative humidity, and soil moisture in balance helps improve crop yield and quality [1], [2], [4]. However, collecting real-time climate data across many points remains difficult. Large-scale farms are spread across wide areas far from residential centers, where Wi-Fi is absent and cellular networks (3G/4G) often have weak coverage (“blank spots”) or require regular mobile data fees for every sensor node [2]–[5]. Meanwhile, inside greenhouses, air temperature, relative humidity, and light intensity directly control plant growth and can change quickly; manual monitoring requires heavy labor, is not continuous, and is too slow to detect harmful conditions in time.
LoRa and LoRaWAN operate in free sub-GHz Industrial, Scientific, and Medical (ISM) frequency bands, send signals over several kilometers with very low power consumption [1], [6], and avoid per-node mobile data fees [5]. This study is guided by the research question: How can a low-power climate monitoring system using LoRa technology be designed to stably collect environmental data in large-scale farms and greenhouses where Wi-Fi and cellular infrastructure is limited? To answer this question, we review six published studies on LoRa/LoRaWAN weather monitoring [1]–[6], build a complete ESP32-S3-N16R8 and LoRa monitoring system, and evaluate a three-day field dataset of 807 packets (November 5–7, 2026).
Project Open-Source Repository, Live Web Dashboard, and System Flowcharts:
- GitHub Repository (Source Code, Schematics & Dataset): https://github.com/iimarky1234/LoRa-Weather-Station .git (https://github.com/iimarky1234/LoRa-Weather-Station.git)
- Live Monitoring Web Dashboard (PWA): https://weather.iimarky123.io.vn/
- System Architecture Flowcharts (GitHub PDF):

https://github.com/iimarky1234/LoRa-Weather-Station/blob/baaa71d1f1d5a8bfd5d371a7b0f6451495bd53da/docs/FlowChart/System%20Architecture%20Flowcharts.pdf

II. LITERATURE REVIEW

A. Comparison with Traditional Wireless Technologies
Short-range wireless modules such as Bluetooth Low Energy (BLE), Zigbee, and Wi-Fi generally operate under 100 m [6], and consumer weather stations such as the AcuRite 5-in-1 and La Crosse WS-2300 reach only 25–100 m to the indoor console [5]. Extending Wi-Fi with special antennas is costly and needs constant power, which was unavailable in the high-Andean farming zones of [4]. Also, cellular modems and satellite transmitters typically draw 4 W and 50 W versus about 0.1 mW for LoRaWAN [3]. Traditional weather stations can cost many thousands of dollars (a Kyrgyz news report cited USD 80,000) versus about USD 1,000 for IoT/LoRaWAN stations; cellular networks also add a regular cost per sensor, while LoRaWAN’s recurring cost is limited to maintenance and the gateway’s cellular service [3]. LoRa uses Chirp Spread Spectrum (CSS) modulation in sub-GHz ISM bands (433, 868, and 915 MHz) with strong resistance to interference [4], [6].
B. LoRa Point-to-Point vs. LoRaWAN Star Network Structures
Published LoRa weather monitoring systems use two main network structures:
- LoRaWAN star-of-stars: Dajnowski et al. [1], Zennaro et al. [3], and Pietrosemoli et al. [5] send end-node packets to a multi-channel gateway (8-channel Dragino LPS8 [1] or Milesight UG67 [3]), which forwards them over TCP/IP to Network and Application Servers [1], [3], [5], such as The Things Network (TTN) [1], [5]. Dajnowski et al. describe AES128 encryption with three keys (AppSKey, DevAddr, NwkSKey) [1], while Pietrosemoli et al. note end-to-end encryption to the Application server [5].
- Point-to-point (P2P) and gateway bridges: Hidayat et al. [2], Lopez et al. [4], and Murdyantoro et al. [6] connect transmitter nodes to a local receiver or gateway (a second ESP32 LoRa node [2], [4] or an LG01-S gateway [6]) that uploads data over Wi-Fi [2], [4], [6]. Hidayat et al. directly choose P2P LoRa [2]. Lopez et al. call their system LoRaWAN-based, but its architecture has only a sender node, a receiver node, and a custom IoT server without a LoRaWAN network server, so we group it with the P2P designs [4].
C. Data Reliability, Visualization, and Transmission Range
Because rural Internet is often unstable, Hidayat et al. [2] applied a Local/Global Management Subsystem (LMS/GMS) where the gateway uses an RTC DS3231 for timestamps and an SD card to save packets during outages before re-uploading. Similarly, Zennaro et al. [3] built a Disruption Tolerant Gateway (DTG) on a Milesight UG67 with MQTT QoS 2 (“exactly once”) whose internal memory holds over two years of messages from one station. For visualization, [1] and [6] used ThingSpeak (up to 8 fields per channel, requiring multiple channels in [1]), while [3] and [4] use InfluxDB or Laravel REST API/MySQL with Grafana dashboards and email, Telegram, or WhatsApp alerts.
LoRa can reach 10 km or more in open areas [1], [6], depending on line of sight (LoS). In high-mountain Peru (3800–4000 m.a.s.l.), Lopez et al. [4] achieved 100% packet delivery over 10 km in LoS and 5 km in a rural area with scattered houses. In contrast, Hidayat et al. [2] tested 915 MHz TTGO LoRa32 modules among buildings and trees: LoS zone D reached 800 m (mean RSSI −114 dB, 20% loss); tree/building zones A and C reached 400 m; and zone B behind a 39 m building reached only 200 m (−124 dB, 80% loss).
D. Embedded Hardware, Sensors, Power, and Literature Gaps
Table I compares the six reviewed systems with our design. Dajnowski et al. [1] and Murdyantoro et al. [6] use Arduino boards, and [1] noted that Arduino memory was stretched to its limits. Hidayat et al. [2], Lopez et al. [4], and Pietrosemoli et al. (LoPy4) [5] use ESP32 boards with sleep modes and built-in Wi-Fi [2], [4]. For temperature, humidity, and pressure, [1], [2], [5], [6] use DHT11, DHT22, BMP180, and BME280 sensors, [4] uses industrial RS485 sensors, and [3] uses the WMO-standard MeteoHelix IoT PRO. Light is measured by TSL2561 [2], a solar radiation sensor [4], or a small solar panel [3], with no dedicated UV index sensor in any study. Soil sensing appears only in [3] (SenseCAP S2105) and [4] (DS18B20 soil temperature, with soil moisture listed as a target variable). For air quality, [1] uses an MQ-135 gas sensor (CO2, CO, NH3, NOx, smoke), and [3] mentions PM2.5/PM10 only in an undeployed 10-in-1 sensor (SenseCAP S1000 V2). Five studies measure wind or rain [1], [3]–[6]. For low power, [5] turns off the 433 MHz receiver (9.9 mA) before deep sleep (32.8 µA), and [4] uses a relay to cut sensor power during sleep (95–120 s) with a 10–15 s warm-up. This review reveals three gaps:
(1) no study tests in a greenhouse or combines air temperature/humidity, light, UV index, soil moisture, and fine dust (PM1.0, PM2.5, PM10) in one low-cost node; (2) Arduino stations face memory limits [1] or lack local backup storage [6]; and (3) direct-powered stations still need battery backup and sleep management during power cuts [3].

TABLE I
COMPARISON OF REVIEWED LORA/LORAWAN WEATHER MONITORING SYSTEMS AND PROPOSED PROJECT DESIGN
Study | MCU & LoRa | Parameters & Sensors | Network & Storage | Power | Range & Findings / Limitations
Dajnowski et al. (2024) [1] | Arduino MCU, Dragino LoRa shield, LPS8 gateway | Temp., humidity (DHT-11/22; BME280 alt.), pressure, wind, rain, light, air quality (MQ-135) | LoRaWAN, TTN, ThingSpeak, Flask web GUI | Battery (solar proposed as future work) | No range test (1–10 km quoted); Arduino memory limits; condensation; fast battery drain.
Hidayat et al. (2019) [2] | ESP32 TTGO LoRa32 V2 (sender & gateway) | Temp., humidity (DHT22), light (TSL2561) | P2P LoRa 915 MHz to Wi-Fi gateway; RTC DS3231 + SD card | Battery + deep sleep | 800 m in LoS (20% loss); 200–400 m with buildings/trees (up to 80% loss).
Zennaro et al. (2025) [3] | Commercial LoRaWAN nodes, Milesight UG67 DTG | Temp., humidity, pressure, irradiation (MeteoHelix), wind, rain, soil moisture (S2105), tilt, river level | LoRaWAN to cellular via MQTT QoS 2; InfluxDB, Grafana | MeteoHelix: solar + Li-ion; gateway: 305 Wp solar + 100 Ah battery | Links to 1.5 km (Tatyr); temp. within 0.5◦C of reference 96.2% of the time.
Lopez et al. (2025) [4] | ESP32 WROOM 32, Ebyte E220-900T22D, MAX485 | Air temp./humidity (CWT-TH04S), soil temp. (DS18B20), solar rad., wind; soil moisture, pressure listed | LoRa 915 MHz to ESP32 Wi-Fi receiver; Laravel REST API, MySQL, Grafana | 37 W solar panel, 8000 mAh 18650 battery, sleep + sensor relay | 10 km (LoS), 5 km (scattered houses), 100% delivery; cost ∼USD 320.
Pietrosemoli et al. (2019) [5] | BSF32 or LoPy4 (ESP32), SX1276, RXB6 433 MHz receiver | Intercepts AcuRite/La Crosse sensors (temp., humidity, wind, rain) + BMP180 pressure | 433 MHz bridged to 868 MHz LoRaWAN (TTN) | BSF32: 2000 mAh Li-ion; LoPy4: 48 Wh pack, 32.8 µA sleep | No field range test; est. battery life 123 days (BSF32), 414 days (LoPy4) at 15 min.
Murdyantoro et al. (2019) [6] | Arduino UNO Rev3, LoRa shield, LG01-S gateway | Temp., humidity (DHT11), pressure (BMP180), raindrop sensor, 3-cup anemometer | LoRa 915 MHz (SF9) to Wi-Fi gateway; ThingSpeak | Power bank | Two nodes matched ThingSpeak; 5–10 km quoted, not measured; no local backup, soil, UV, or dust.
Proposed (Group 2) | ESP32 (ESP32-S3-N16R8), MKE-M24 Ra-02SH (SX1278), 525 MHz 3.5 dBi antenna | Air temp./humidity (AM2301B), light (BH1750), UV (LTR390), soil moisture (Grove), fine dust PM1.0/PM2.5/PM10 (APM10) | LoRa P2P (434 MHz, SF12); RTC DS1307, MicroSD + 16 MB Flash backup, ThingSpeak & Local PWA | Direct power + 10,000 mAh Li-Po backup + deep sleep | Theoretical 5–10 km (rural), ∼1 km (urban tests, 807 packets, mean RSSI −76.77 dBm); no wind sensor.

III. SYSTEM ARCHITECTURE AND HARDWARE DESIGN

A. Overall System Architecture
Figure 1 shows the system block diagram, which separates field sensing from Internet upload using a Weather Station Node in the farm or greenhouse and a Central Gateway where Wi-Fi access is available. In addition to the Node and Gateway (firmware/node/ and firmware/gateway/), our repository also provides an all-in-one Standalone Station (firmware/standalone/) for single-board local logging and cloud upload without LoRa, as well as a Repeater workflow in the system design flowcharts to forward packets across longer distances.

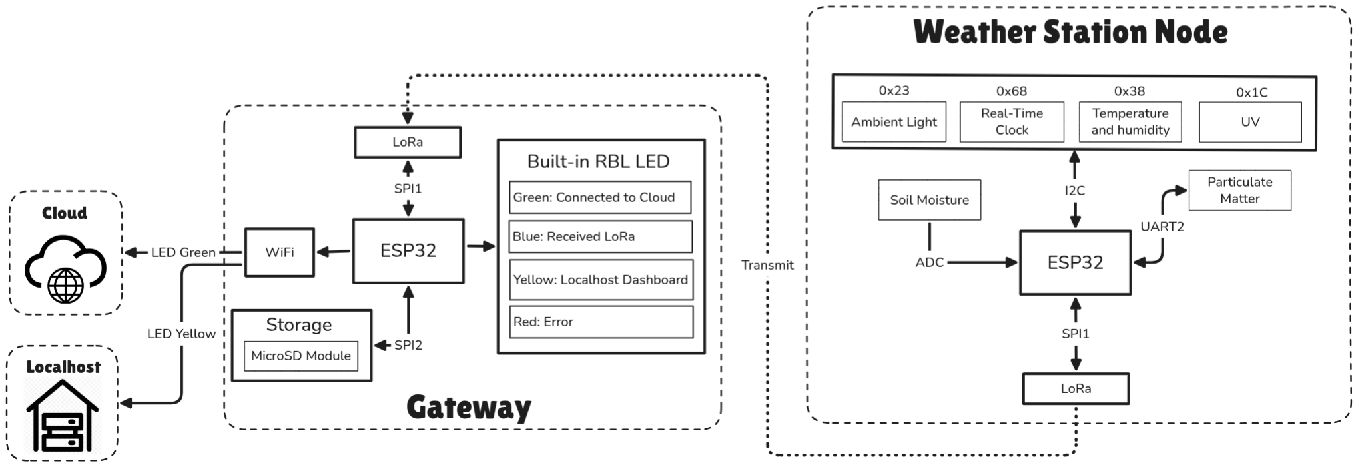
[picture p5: figure]

Fig. 1. System block diagram of the ESP32-based Weather Station Node and Central Gateway showing I²C addresses (0x23, 0x68, 0x38, 0x1C), ADC, UART, SPI1/SPI2 buses, status LED colors, and Cloud/Localhost paths.
As shown in Fig. 1, the Weather Station Node uses an ESP32 (ESP32-S3-N16R8) to read three sensor interfaces: a shared I

2C bus for Ambient Light (0x23), Real-Time Clock (0x68), Temperature/Humidity (0x38), and UV (0x1C); an analog ADC channel for Soil Moisture; and a UART interface for the Particulate Matter sensor. Readings are packed into a 26-byte binary packet and sent via LoRa on SPI1. The Central Gateway receives LoRa packets via SPI1, saves CSV records to a MicroSD card on SPI2 (with automatic 16 MB internal flash backup), displays system status on its built-in RGB LED (Green for Cloud, Blue for Received LoRa, Yellow for Localhost Dashboard, Red for Error), and forwards data over Wi-Fi to ThingSpeak Cloud or a local web dashboard.

B. Sensor Node and Central Gateway Circuit Schematics
Figures 2 and 3 show the Sensor Node and Central Gateway circuit schematics (Rev. 1.0), and Table II summarizes the hardware connections and LoRa radio settings. Each station is built from the project hardware list: one unit each (1c) of ESP32 (ESP32-S3-N16R8), AM2301B temperature and humidity sensor (H3 AM2301b), MKE-M24 Ra-02SH LoRa module (L1 RA-02SH, Ai-Thinker Ra-02 / Semtech SX1278), BH1750 I

2C light sensor (1 LIGHT-SENSOR-BH1750), Grove Soil Moisture Sensor (4 SOIL-MOISTURE-SENSOR), 525 MHz 3.5 dBi LoRa antenna, MKE-M09 RTC DS1307 (U2 DS1307_RTC), MicroSD reader (U3 MICROSD_READER), LTR390 UV sensor (H2 LTR390 UV Light), APM10 fine dust sensor (H1 APM10), and a 10,000 mAh Li-Po battery.

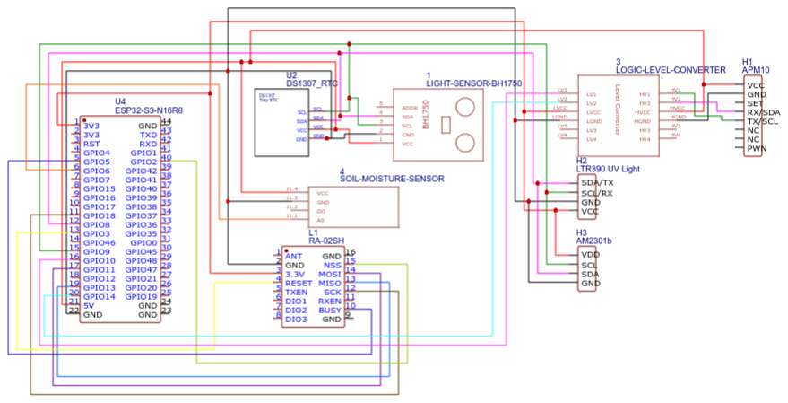
[picture p6: figure]

Fig. 2. Circuit schematic of the Sensor Node (U4 ESP32-S3-N16R8, L1 RA-02SH, U2 DS1307_RTC, 1 LIGHT-SENSOR-BH1750, 3 LOGIC-LEVEL-CONVERTER, 4 SOIL-MOISTURE-SENSOR, H1 APM10, H2 LTR390 UV Light, and H3 AM2301b).

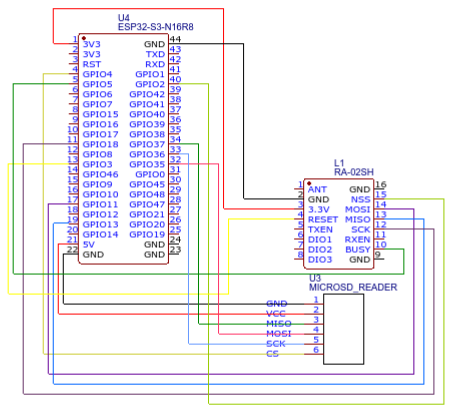
[picture p7: figure]

Fig. 3. Circuit schematic of the Central Gateway (U4 ESP32-S3-N16R8, L1 RA-02SH on SPI1, and U3 MICROSD_READER on separate SPI2).
On the Sensor Node (Fig. 2), the shared 100 kHz I²C bus on GPIO8 (SDA) and GPIO9 (SCL) connects the DS1307 RTC, BH1750, LTR390, and AM2301B sensors powered from the 3V3 pin. The Grove Soil Moisture analog output (AO) connects to GPIO6 (0–3.3 V ADC input, calibrated in drivers/soil.py between 2800 mV dry and 1200 mV wet). Because the APM10 dust sensor uses 5.0 V power while the ESP32-S3 uses 3.3 V logic, a Logic-Level Converter (3 LOGIC-LEVEL-CONVERTER) safely shifts the 1200-baud UART lines between GPIO10 (TX) and GPIO14 (RX) on the ESP32-S3 and the APM10 sensor. The station runs on direct electrical power with the 10,000 mAh Li-Po battery as backup during power cuts.

On both the Node and Gateway, the RA-02SH LoRa module connects to the ESP32-S3 via SPI1: SCK to GPIO18, MISO to GPIO13, MOSI to GPIO11, NSS (CS) to GPIO2, and RESET to GPIO3 (with the interrupt line wired to GPIO5 on the Node schematic and GPIO6 on the Gateway). On the Central Gateway (Fig. 3), the MICROSD_READER uses a separate SPI2 bus on GPIO36 (SCK), GPIO35 (MOSI), GPIO37 (MISO), and GPIO4 (CS) so that reading or writing CSV files on the MicroSD card never interferes with incoming LoRa packets on SPI1.

TABLE II
ESP32-S3-N16R8 HARDWARE PINOUT MAPPING AND SX1278 LORA RADIO SETTINGS
Subsystem / Parameter | ESP32-S3 Pin / Value | Connected Component | Interface & Function in System

Part A: Sensor Node & Central Gateway Hardware Pinout (ESP32-S3-N16R8)
Shared I²C Bus (Node) | GPIO8 (SDA),
| GPIO9 (SCL) | DS1307, BH1750, LTR390,
| | AM2301B | 100 kHz I²C bus (addresses 0x68, 0x23, 0x1C, 0x38)
APM10 UART (Node) | GPIO10 (TX),
| GPIO14 (RX) | APM10 Dust Sensor (via Level
| | Shifter) | 1200-baud UART reading PM1.0, PM2.5, and PM10 (3.3 V ↔ 5 V)
Soil Moisture ADC (Node) | GPIO6 | Grove Soil Moisture Sensor (AO) | Analog ADC input (0–3.3 V; 2800 mV dry to 1200 mV wet)
LoRa SPI1 Bus (Both) | GPIO18 / 11 / 13 | Ra-02SH SCK / MOSI / MISO | Dedicated SPI1 bus for LoRa radio communication
LoRa Control Pins (Both) | GPIO2 (CS),
| GPIO3 (RST) | Ra-02SH NSS / RESET (& DIO) | Chip Select and Reset (GPIO5 on Node; GPIO6 on Gateway)
MicroSD SPI2 (Gateway) | GPIO36 / 35 / 37
| / 4 | MicroSD SCK / MOSI / MISO /
| | CS | Separate SPI2 bus for CSV data logging to MicroSD card
Status RGB LED (Both) | GPIO48 / GPIO38 | Built-in WS2812 RGB LED | Displays Green, Yellow, Blinking Grey, Blue Flash, or Red
Power Pins (Both) | 3V3, 5V, GND | Sensors, RTC, Level Shifter,
| | Ra-02SH, SD | 3.3 V for MCU/sensors/LoRa; 5.0 V for APM10 and Level Shifter

Part B: LoRa Radio Configuration (firmware/node/config.py & firmware/gateway/config.py)
Carrier Frequency | 434.00 MHz | MKE-M24 Ra-02SH (SX1278) | License-free sub-GHz ISM frequency band
Spreading Factor & BW | SF12, 15.6 kHz | MKE-M24 Ra-02SH (SX1278) | High spreading factor and narrow bandwidth for long range
Coding Rate & Preamble | 4/5, 8 symbols | MKE-M24 Ra-02SH (SX1278) | Forward error correction and packet synchronization header
Transmit Power & Sync | +20 dBm, 0x12 | MKE-M24 Ra-02SH (SX1278) | Maximum 100 mW transmit power and private network sync word
Low Data Rate Opt. | Enabled (Auto) | MKE-M24 Ra-02SH (SX1278) | Keeps clock synchronization stable during slow SF12 packets

IV. FIRMWARE ARCHITECTURE AND COMMUNICATION PROTOCOL

A. LoRa Radio Configuration and 26-Byte Binary Protocol
As shown in Table II (Part B), both the Sensor Node and Central Gateway configure their SX1278 LoRa modules (common/sx1278.py) with the same radio parameters in config.py: 434.00 MHz frequency, spreading factor SF12, 15.6 kHz bandwidth,
coding rate 4/5, and +20 dBm transmit power. Choosing SF12 and +20 dBm gives the radio signal strong penetration
through greenhouse frames, trees, and buildings. Because SF12 sends data slowly to achieve long range, sending long JSON
text strings would take too much airtime and battery power. Instead, common/protocol.py packs all sensor readings into a compact 26-byte binary packet. Table III shows the exact byte layout and ThingSpeak cloud field mapping. To keep two decimal places without using large floating-point numbers, decimal readings (temperature, relative humidity, soil moisture, and UV index) are multiplied by 100 before packing and divided by 100 when decoded at the Gateway.

TABLE III
26-BYTE BINARY LORA PACKET STRUCTURE (C O M M O N/P R O T O C O L.P Y) AND THINGSPEAK CLOUD FIELD MAPPING
Byte Offset | Field Name | Size | Binary Encoding | Measurement Unit / Resolution | ThingSpeak Cloud Field Mapping
0 | Node ID | 1 Byte | Whole number (1–255) | Station identifier (node_id =
| | | | 1) | Selects Node 1 or Node 2 channel
1 - 2 | Sequence Number | 2 Bytes | Whole number (0–65,535) | Packet counter (seq) | Saved in ESP32 RTC memory
3 | Mesh Hops | 1 Byte | Whole number (0–255) | Repeater hop count (hops) | Tracks repeater forwarding steps
4 - 7 | Timestamp | 4 Bytes | Unix epoch seconds | Seconds since 1970-01-01 (1 s
| | | | step) | Converted to YYYY-MM-DD
| | | | | HH:MM:SS
8 - 9 | Air Temperature | 2 Bytes | Temperature × 100 (signed) | Degrees Celsius (0.01 ◦C step) | Field 1: Temperature (◦C)
10 - 11 | Relative Humidity | 2 Bytes | Humidity × 100 | Percent 0.00–100.00% (0.01%
| | | | step) | Field 2: Relative Humidity (%)
12 - 13 | Ambient Light | 2 Bytes | Whole number Lux | Illuminance in Lux (1 Lux step) | Field 3: Ambient Light (Lux)
14 - 15 | Soil Moisture | 2 Bytes | Soil Moisture × 100 | Percent 0.00–100.00% (0.01%
| | | | step) | Field 8: Soil Moisture (%)
16 - 17 | UV Raw Count | 2 Bytes | Whole number sensor count | Raw LTR390 UV count | Internal UV sensor check
18 - 19 | UV Index | 2 Bytes | UV Index × 100 | UV Index (0.01 UVI step) | Field 4: Ultraviolet Index (UVI)
20 - 21 | Fine Dust PM1.0 | 2 Bytes | Whole number concentration | µg/m³ (1 µg/m³
| | | | step) | Field 7: PM1.0 (µg/m³ )
22 - 23 | Fine Dust PM2.5 | 2 Bytes | Whole number concentration | µg/m³ (1 µg/m³
| | | | step) | Field 5: PM2.5 (µg/m³ )
24 - 25 | Fine Dust PM10 | 2 Bytes | Whole number concentration | µg/m³ (1 µg/m³
| | | | step) | Field 6: PM10 (µg/m³ )
B. Firmware Workflows, Power Saving, and Web Dashboard
For easy viewing, the four official system architecture flowcharts (Flowchart 1 — Standalone Sensor, Flowchart 2 — Gateway, Flowchart 3 — Repeater, and Flowchart 4 — Sensor Node) are linked on a separate line below:
System Architecture Flowcharts (Click to Open GitHub PDF):

https://github.com/iimarky1234/LoRa-Weather-Station/blob/baaa71d1f1d5a8bfd5d371a7b0f6451495bd53da/docs/FlowChart/System%20Architecture%20Flowcharts.pdf

1) Sensor Node (firmware/node/, Flowchart 4): On startup or wake-up from deep sleep, node/main.py loads node/config.py, reads the saved packet sequence counter from the ESP32 RTC memory, turns on the status LED, and initializes the I²C bus, the six sensor drivers (ds1307.py, bh1750.py, am2301b.py, ltr390.py, apm10.py, and soil.py), and the SX1278 LoRa module. In each cycle, it reads the timestamp from the DS1307 RTC (or uses the system clock if the RTC is offline) and collects measurements from all five environmental sensors (using safe zero defaults if any sensor fails to respond). It then packs the data into a 26-byte binary frame (common/protocol.py), flashes the Blue LED, and sends the packet over LoRa (lora.send()). Although the system flowchart also outlines an optional ACK and retry loop, the deployed firmware uses a direct broadcast mode to minimize radio on-time: once transmission finishes, it increments and saves the sequence counter to RTC memory, puts the LoRa chip into sleep mode (lora.sleep(), ∼ 0.2 µA), turns off the RGB LED, and enters ESP32 deep sleep (machine.deepsleep()) for
TX_INTERVAL_SEC = 60 seconds.
2) Central Gateway (firmware/gateway/, Flowchart 2): At boot, gateway/main.py loads gateway/config.py, initializes the status LED, and sets up dual storage (gateway/storage.py). It first tries to mount the MicroSD card (/sd/gateway_weather_log.csv); if no card is inserted or a write error happens later, it automatically switches to the 16 MB internal flash memory (/gateway_weather_log.csv) while also keeping the 50 newest records in a RAM buffer. Next, it initializes the SX1278 receiver and tries to connect to Wi-Fi for up to 12 seconds (blinking the Grey LED). Two asynchronous tasks then run in parallel:
- LoRa Receiver Task: Keeps the SX1278 in continuous receive mode. Whenever a valid 26-byte packet arrives with a valid hardware CRC check, it reads the packet’s RSSI and SNR, flashes the Blue LED, appends a CSV row to the MicroSD card (or internal flash), and updates the latest node data in memory.
- Cloud and Failover Web Task: When Wi-Fi is connected (Online Mode, Solid Green LED), the gateway uploads new sensor data to ThingSpeak every 20 seconds (Channel 3543024 for Node 1 and Channel 3558474 for Node
2) while keeping the local web server off to save memory. If Wi-Fi fails at boot, the gateway starts a local Wi-Fi
hotspot (WeatherStation-ESP32 at 192.168.4.1) with a captive portal DNS server (dns_server.py)
and local web dashboard (web_server.py, Solid Yellow LED). Similarly, if ThingSpeak fails 3 times in a row during normal operation, the gateway automatically opens the local web dashboard at http://<local_ip>/(Solid Yellow LED) and retries ThingSpeak every 60 seconds, switching back to Online Mode (Solid Green LED) once the cloud connection recovers.
3) Standalone Station (firmware/standalone/, Flowchart 1): Designed for single-location setups where LoRa is not needed, standalone/main.py connects the sensors and MicroSD card directly to one ESP32-S3 board. It syncs the DS1307 RTC with an Internet NTP time server (pool.ntp.org, UTC+7) at boot, reads all sensors every 20 seconds, saves CSV logs to MicroSD or internal flash, uploads to ThingSpeak, and uses the same automatic Yellow-LED local web dashboard fallback if Wi-Fi or ThingSpeak goes offline.
4) Repeater (Flowchart 3): To extend range past obstacles, the system architecture includes a Repeater workflow supported by the hops field (Byte 3) in common/protocol.py. A repeater listens in continuous receive mode, checks packet validity, drops duplicate packets or packets that have reached the maximum hop limit, increases the hop count by one, waits a short random delay to avoid signal collisions, and re-transmits the packet toward the Central Gateway.
In addition to the built-in local dashboard on the ESP32-S3 (web_server.py, which serves /, /api/data, /api/history, and /download), the project provides a public cloud-synced Progressive Web App (webapp/index.html, live at https: //weather.iimarky123.io.vn/). It displays an interactive map of sensor nodes, live sensor cards, historical charts, active storage status (MicroSD (/sd), Internal Flash (16MB), or RAM Buffer Only), and one-click CSV data downloads.
V. EXPERIMENTAL SETUP AND FIELD RESULTS
A. Three-Day City Test and Dataset Collection
The prototype (Node 1, node_id = 1, sending data to the Central Gateway) was tested in an urban environment over three consecutive days (November 5–7, 2026). All received packets were saved in gateway_weather_log.csv, producing 807 valid sensor data records with zero missing or corrupted values:
- Day 1 (2026-11-05): n = 261 records from 12:29:13 to 16:48:15 (4 h 19 min 02 s); time between packets ranged from 48.0 s to 72.0 s with a mean of 59.78 s (SD = 7.38 s).
- Day 2 (2026-11-06): n = 273 records from 12:26:06 to 16:58:55 (4 h 32 min 49 s); time between packets ranged from 48.0 s to 72.0 s with a mean of 60.18 s (SD = 7.27 s).
- Day 3 (2026-11-07): n = 273 records from 12:05:25 to 16:38:52 (4 h 33 min 27 s); time between packets ranged from 48.0 s to 72.0 s with a mean of 60.32 s (SD = 7.10 s).

Across all 804 within-day intervals, the overall mean interval was 60.10 s (SD = 7.24 s), matching the 60-second deep-sleep cycle configured in node/config.py. Table IV summarizes the overall and daily statistics, and Fig. 4 plots the 30-minute average line charts (12:00 to 16:30) across all N = 807 records.

TABLE IV
STATISTICAL SUMMARY OF THE THREE-DAY FIELD TEST DATASET (G A T E W A Y_W E A T H E R_L O G.C S V, NODE 1, N = 807 RECORDS; DAILY COLUMNS REPORT MEAN ± SD)
Parameter (Unit) | Min | Max | Mean | Median | SD | Day 1 (n = 261) | Day 2 (n = 273) Day 3 (n = 273)
Temperature (◦C) | 28.50 | 34.24 | 31.98 | 32.16 | 1.32 | 32.00 ± 1.36 | 32.03 ± 1.29 31.92 ± 1.30
Relative Humidity (%) | 59.92 | 95.66 | 70.23 | 67.66 | 8.42 | 70.17 ± 8.56 | 69.86 ± 8.45 70.67 ± 8.25
Ambient Light (Lux) | 2047.90 | 64645.80 | 33549.71 | 32016.90 | 21083.72 | 32532.12 ±
| | | | | | 20992.79 | 32288.32 ±
| | | | | | | 20635.35 35783.96 ± 21507.07
Soil Moisture (%) | 47.20 | 92.80 | 64.68 | 53.00 | 18.57 | 65.19 ± 18.72 | 66.08 ± 19.00 62.80 ± 17.91
UV Index (UVI) | 0.00 | 8.46 | 4.25 | 4.10 | 2.67 | 4.11 ± 2.67 | 4.09 ± 2.61 4.54 ± 2.71
PM1.0 (µg/m³
) | 3.00 | 21.00 | 12.73 | 13.00 | 3.61 | 12.59 ± 3.68 | 12.80 ± 3.63 12.78 ± 3.52
PM2.5 (µg/m³
) | 5.00 | 49.00 | 25.60 | 28.00 | 8.74 | 25.38 ± 8.91 | 25.92 ± 9.00 25.50 ± 8.34
PM10 (µg/m³
) | 8.00 | 112.00 | 46.14 | 51.00 | 17.75 | 45.50 ± 18.29 | 46.93 ± 18.35 45.95 ± 16.60
RSSI (dBm) | −90.00 | −65.00 | −76.77 | −77.00 | 4.00 | −76.92 ± 3.97 | −76.86 ± 4.05 −76.53 ± 3.96
SNR (dB) | 2.80 | 13.50 | 9.05 | 9.10 | 1.67 | 9.00 ± 1.70 | 9.03 ± 1.60 9.12 ± 1.70
(a) Air Temp. (◦C), Rel. Humidity (%) & Soil Moisture (%)
Temp. (◦C, R) | Hum. (%, L) | Soil (%, L)

40%

55%

70%

85%

100%

28.0◦

29.5◦

31.0◦

32.5◦

34.0◦

12:00 | 12:30 | 13:00 | 13:30 | 14:00 | 14:30 | 15:00 | 15:30 | 16:00 | 16:30
(b) Ambient Light (kLux) & UV Index (UVI)
Light (kLux, L) | UV Index (UVI, R)

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
10.0

12:00 | 12:30 | 13:00 | 13:30 | 14:00 | 14:30 | 15:00 | 15:30 | 16:00 | 16:30
(c) Particulate Matter PM1.0, PM2.5 & PM10 (µg/m³ )
PM10 | PM2.5 | PM1.0

0

20

40

60

80

12:00 | 12:30 | 13:00 | 13:30 | 14:00 | 14:30 | 15:00 | 15:30 | 16:00 | 16:30

Time of Day (HH:MM, 30-Minute Bins Across N = 807 Records)

(d) LoRa Radio Link RSSI (dBm) & SNR (dB)
RSSI (dBm, L) | SNR (dB, R)

-81

-79

-77

-75

-73

6.0 dB

7.0 dB

8.0 dB

9.0 dB

10.0 dB

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

Time of Day (HH:MM, 30-Minute Bins Across N = 807 Records)

Fig. 4. Half-hour time-of-day line charts (12:00 to 16:30) of the three-day field test dataset (gateway_weather_log.csv, Node 1, N = 807 records across 10 thirty-minute bins: n = 31, 89, 89, 87, 90, 89, 93, 90, 90, 59) showing (a) Air Temperature (◦C, right axis) vs. Relative Humidity and Soil Moisture (%, left axis), (b) Ambient Light (kLux, left axis) and UV Index (UVI, right axis), (c) Fine Dust PM1.0, PM2.5, and PM10 (µg/m³
), and (d) LoRa RSSI
(dBm, left axis) and SNR (dB, right axis).
B. Local Climate, Soil, Dust, and Radio Link Observations
As shown in Table IV and the line charts in Fig. 4, the sensor node recorded clear daily weather patterns across all three afternoons:
1) Air Temperature and Relative Humidity (AM2301B, Fig. 4(a)): Daily temperature ranges were 28.84–34.24 ◦C on Day 1, 28.81–34.21 ◦C on Day 2, and 28.50–34.08 ◦C on Day 3, while relative humidity ranged from 59.92–95.57%, 61.17–95.66%, and 60.85–94.59%. Temperature and relative humidity moved in opposite directions: as afternoon temperature rose from 30.87–31.66 ◦C at midday to a peak of 34.08–34.24 ◦C around 14:15-14:55 (bin mean 33.65 ◦C at 14:30), relative humidity dropped to 59.92–60.85% (bin mean 62.48%). Later, between 15:25 and 15:50, temperature cooled to 28.50–28.84 ◦C (bin mean 29.55 ◦C at 15:30) while relative humidity rose to 94.59–95.66% (bin mean 88.42%).
2) Ambient Light (BH1750) and UV Index (LTR390, Fig. 4(b)): Light intensity and UV index closely followed the same daily curve. Daily light ranges were 2096.00–63, 195.30 Lux (UVI 0.00–8.18) on Day 1, 2084.70–63, 462.30 Lux (UVI 0.00–8.05) on Day 2, and 2047.90–64, 645.80 Lux (UVI 0.00–8.46) on Day 3. Both readings reached their highest levels around 12:07-12:30 (bin mean 58.66 kLux and UVI 7.38 at 12:30), dropped sharply during the cloudy/wet period at 15:30 (bin mean 4.80 kLux and UVI 0.58, reaching UVI 0.00 in 8 packets), and rose slightly to 17.70 kLux (UVI 2.26) at 16:00 before sunset.

3) Soil Moisture (Grove Sensor) and Fine Dust (APM10, Fig. 4(a, c)): Soil moisture began around 52.9–53.2% at midday, slowly dried to 47.20–48.00% by 14:55-15:00 (bin mean 48.78% at 14:30), and then jumped to 90.4–92.2% at 15:10-15:30 after watering/rain, staying at 90.1–92.8% for the rest of the afternoon (bin means 91.90–91.95% at 15:30-16:00). At the same time, PM1.0 (3.00–21.00 µg/m³

), PM2.5 (5.00–49.00 µg/m³ ), and PM10
(8.00–112.00 µg/m³

) moved together, dropping to their lowest levels (3, 5, and 8 µg/m³ ; bin means 6.07, 9.17, and 13.73 µg/m³
at 15:30) during the high-humidity period around 15:30-15:45.
4) LoRa Radio Link Performance (RSSI and SNR, Fig. 4(d)): Across all 807 packets, RSSI stayed between −90.00 and −65.00 dBm (mean −76.77 dBm, median −77.00 dBm each day, SD = 4.00 dBm) and SNR remained positive between 2.80 and 13.50 dB (mean 9.05 dB). Compared with the −114 to −124 dB RSSI levels where Hidayat et al.
[2] saw 20%–80% packet loss, our LoRa link maintained a strong signal and stable 1-minute data delivery.

VI. DISCUSSION AND LIMITATIONS

A. Addressing Literature Gaps and Design Benefits
The proposed system addresses all three gaps identified in Section II. First, unlike outdoor weather stations focused mainly on wind and rain [1], [3]–[6] without UV index or deployed fine dust sensors, our node combines five sensors measuring eight environmental parameters (air temperature, relative humidity, ambient light, UV index, soil moisture, PM1.0, PM2.5, and PM10) suitable for both greenhouses and open farms. Second, the ESP32-S3-N16R8 overcomes the Arduino memory limits reported in [1] and supports a compact 26-byte binary protocol, dual gateway storage (MicroSD card plus 16 MB internal flash backup and a 50-record RAM buffer), and automatic switching between ThingSpeak Cloud and a local offline web dashboard. Third, combining direct electrical power with a 10,000 mAh Li-Po backup battery, RTC-saved packet counters, and 60-second deep sleep keeps the sensor node running smoothly during power outages.
B. Limitations
First, our current prototype does not include wind speed and wind direction sensors, unlike [1], [3]–[6]. While wind is minimal inside closed greenhouses, it is an important factor for open-field farms because wind affects plant water loss and the metabolism rate of many plant species [1]. Second, although the LoRa module and 525 MHz 3.5 dBi antenna can theoretically reach 5–10 km in open rural areas—similar to the 5–10 km rural links demonstrated in [4] and ranges quoted in [1], [6]— our field tests were conducted in an urban environment, where dense buildings and obstacles currently limit the effective transmission distance to about 1 km, consistent with the urban signal loss reported by Hidayat et al. [2].

VII. CONCLUSION
This paper presented a low-power LoRa-based climate monitoring system for large-scale farms and greenhouses where Wi-Fi and cellular coverage is limited. Built on the ESP32-S3-N16R8 microcontroller and MKE-M24 Ra-02SH (Semtech SX1278) LoRa module, the system connects AM2301B, BH1750, LTR390, Grove Soil Moisture, and APM10 sensors with DS1307 RTC timekeeping, a 10,000 mAh Li-Po backup battery, deep-sleep power management, dual MicroSD/flash gateway storage, ThingSpeak cloud streaming, and a local backup web dashboard. Across a three-day urban field test (November 5–7, 2026), the station reliably logged 807 packets at a 60.10 s mean interval with a mean RSSI of −76.77 dBm and mean SNR of 9.05 dB. Future work will add wind sensors for open farms, test multi-hop repeater forwarding, and evaluate 5–10 km range in open rural farmland.

REFERENCES

[1] N. Dajnowski, A. Guest, A. B. Usman, A. Abba, and S. R. Sabuj, “A low-cost IoT-based meteorological system using LoRaWAN and embedded technologies: Architecture and future trends,” International Journal of Computer Vision and Signal Processing, vol. 14, no. 1, pp. 68–77, Feb. 2024.
[2] M. S. Hidayat, A. P. Nugroho, L. Sutiarso, and T. Okayasu, “Development of environmental monitoring systems based on LoRa with cloud integration for rural area,” in IOP Conference Series: Earth and Environmental Science, vol. 355, no. 1. IOP Publishing, 2019, p. 012010.
[3] M. Zennaro, E. Pietrosemoli, A. Soltobaev, T. Sultanov, and B. Moldobekov, “From mountains to data: low-cost weather stations in Kyrgyzstan’s challenging terrain,” Frontiers in Communications and Networks, vol. 6, p. 1505375, May 2025.
[4] G. Quea Lopez, A. R. Condori Coaquira, J. E. Otazu Luque, and E. Gutierrez Quispe, “LoRaWAN-based system for multivariate data acquisition in high Andean agriculture,” Smart Agricultural Technology, vol. 12, p. 101569, Oct. 2025.
[5] E. Pietrosemoli, M. Rainone, and M. Zennaro, “On extending the wireless communications range of weather stations using LoRaWAN,” in Proceedings of the 5th EAI International Conference on Smart Objects and Technologies for Social Good (GoodTechs ’19). Valencia, Spain: ACM, Sep. 2019, pp. 78–83.
[6] E. Murdyantoro, R. Setiawan, I. Rosyadi, A. W. W. Nugraha, H. Susilawati, and Y. Ramadhani, “Prototype weather station uses LoRa wireless connectivity infrastructure,” in Journal of Physics: Conference Series, vol. 1367, no. 1. IOP Publishing, 2019, p. 012089.

AI USAGE DECLARATION | IOT102 | Fall 2026

Group: 2

Topic: LoRa-Based Climate Monitoring System for Large-Scale Farms and Greenhouses

□ We did NOT use AI-generated tools in this report.

✓□ We DO use AI (check all appropriate purposes)

Tools: Gemini

Purpose:
✓□ System / architecture design exploration

□ Hardware / protocol selection research

✓□ Code generation / debugging

✓□ Data analysis support

□ Literature exploration

✓□ Technical writing / language editing

□ Other: |

We confirm that all engineering decisions, evaluation results, and conclusions presented in this report are the product of the team’s own thinking..
