iimarky1234/LoRa-Weather-Station/assets/crop_left.png

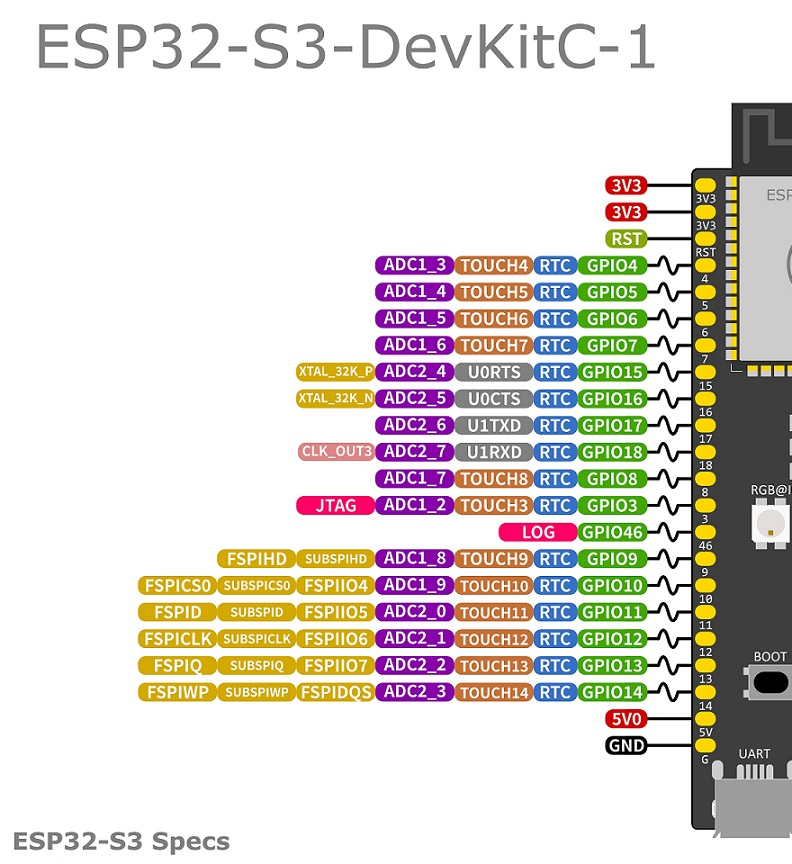
assets/crop_left.png
