iimarky1234/LoRa-Weather-Station/assets/info.png

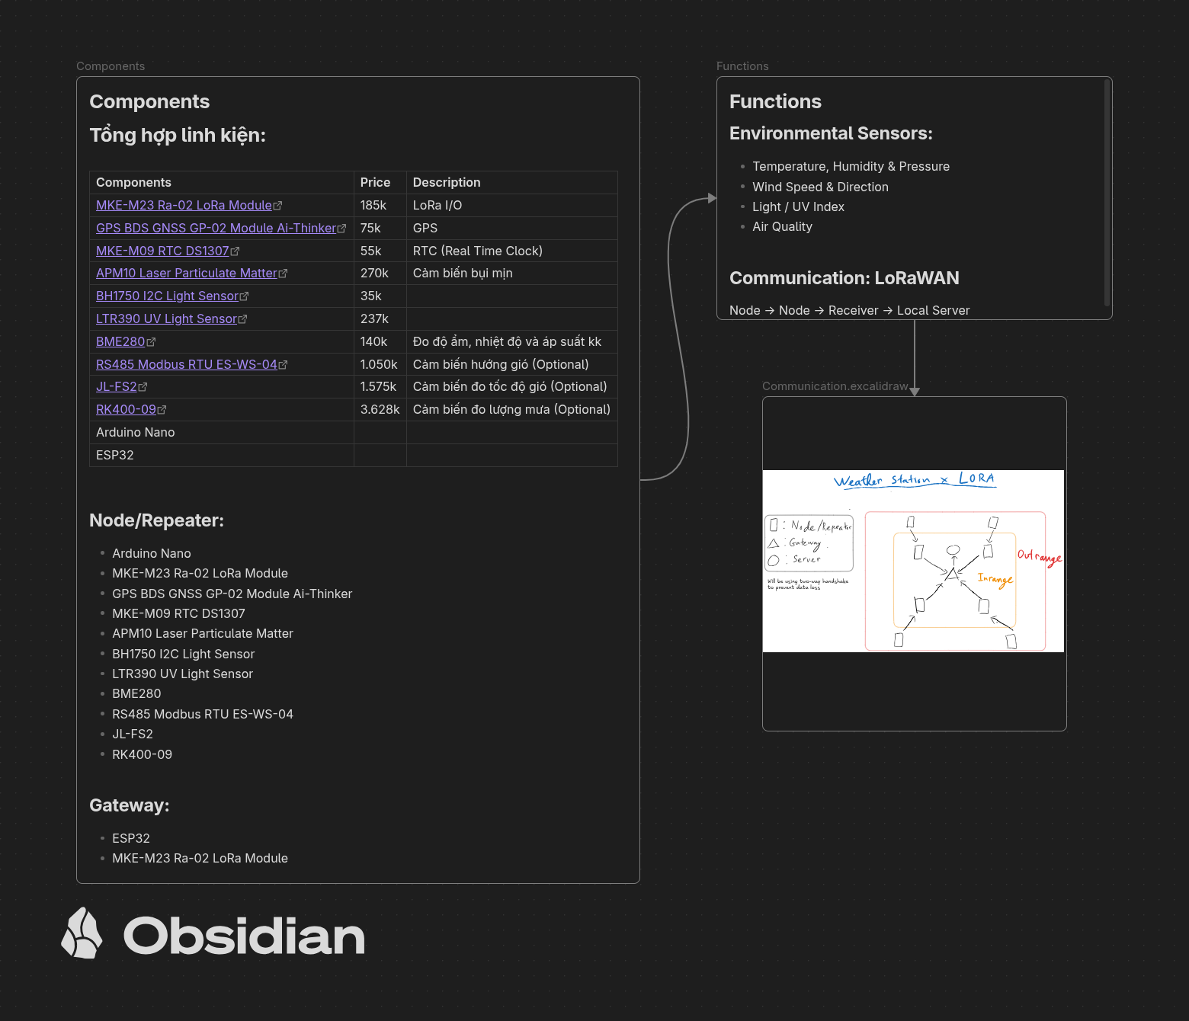
assets/info.png
