iimarky1234/LoRa-Weather-Station/assets/Localhost.png

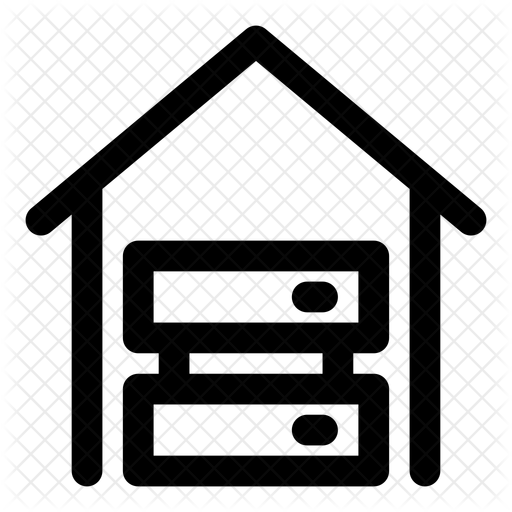
assets/Localhost.png
