iimarky1234/LoRa-Weather-Station/assets/Pasted image 20261008172738.png

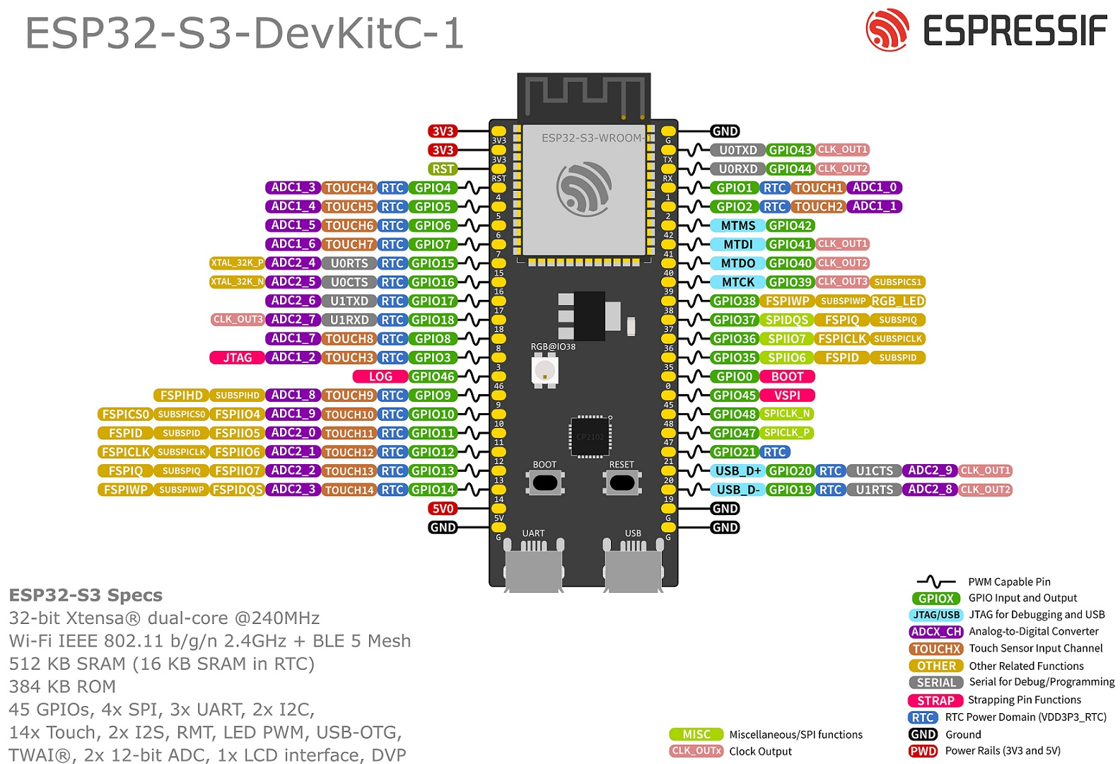
assets/Pasted image 20261008172738.png
