iimarky1234/LoRa-Weather-Station/docs/Block_Diagram/Block_Diagram_Repeater.png

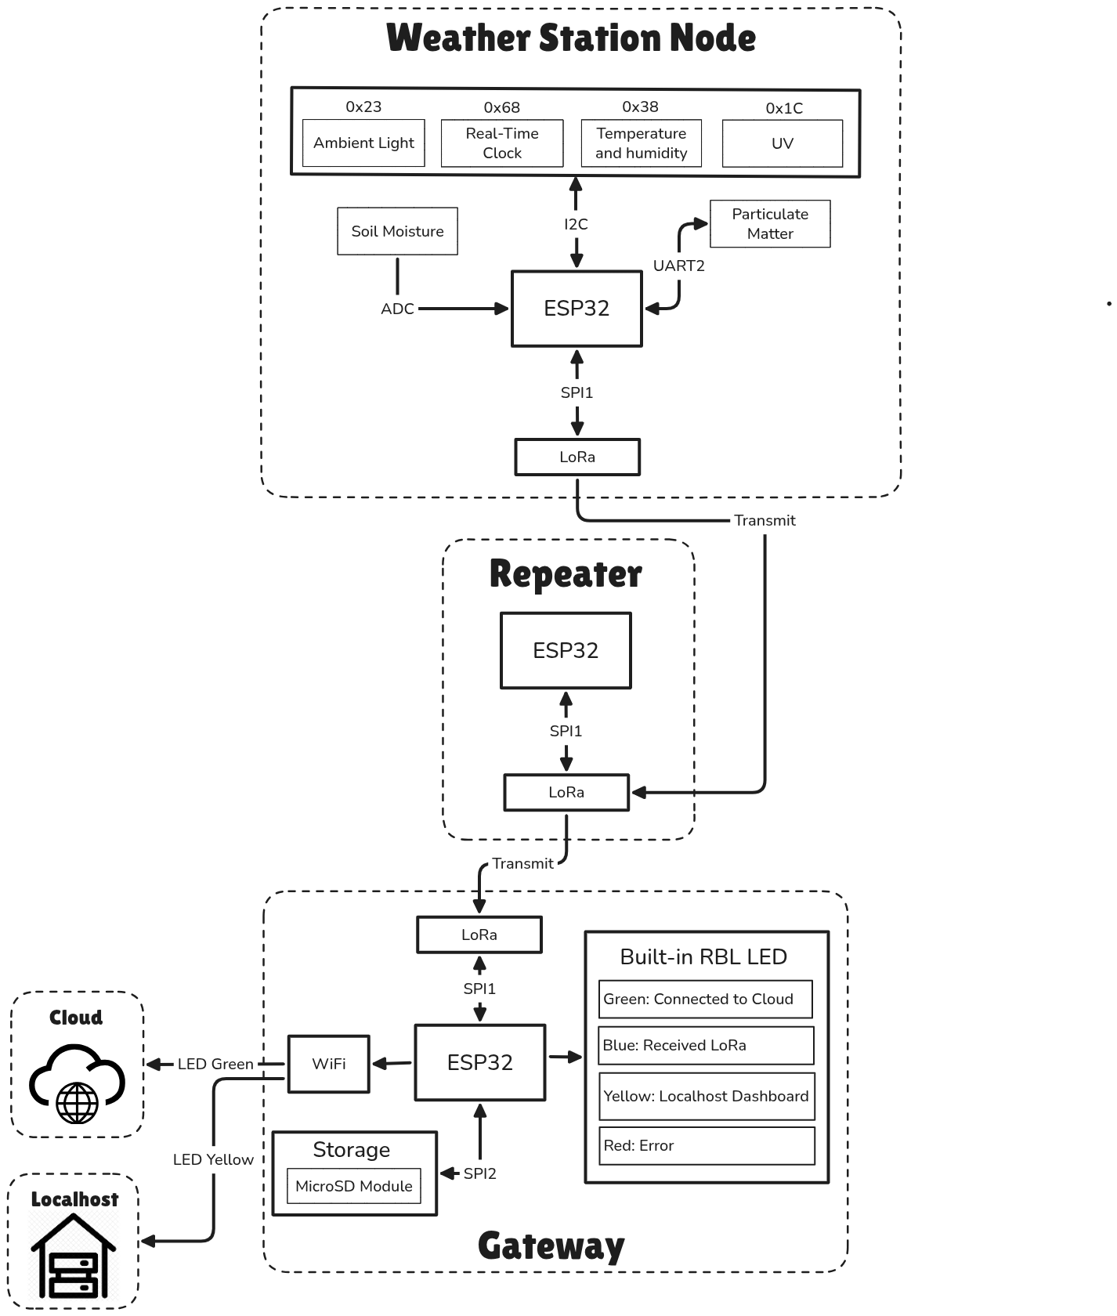
docs/Block_Diagram/Block_Diagram_Repeater.png
