iimarky1234/LoRa-Weather-Station/Excalidraw/com.png

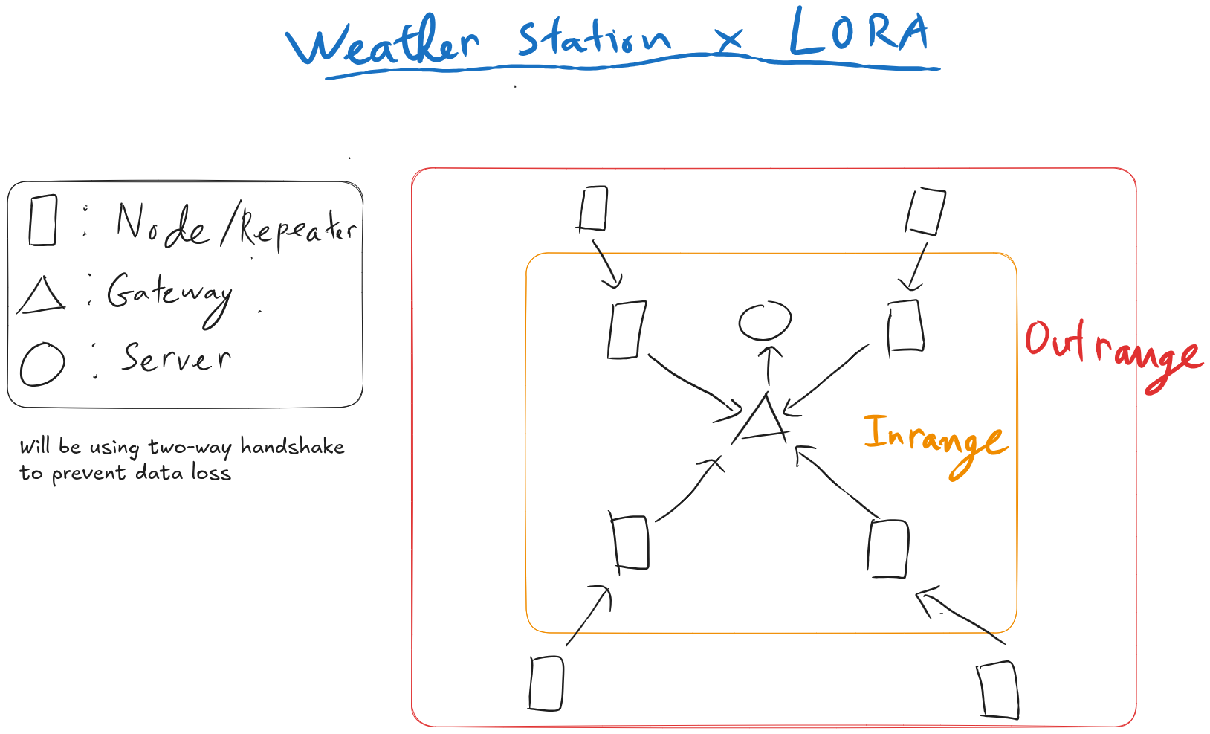
Excalidraw/com.png
