iimarky1234/LoRa-Weather-Station/docs/Components.md

## Node/Repeater

- ESP32-S3
- MKE-M23 Ra-02 LoRa Module
- MKE-M09 RTC DS1307 x 1
- APM10 Laser Particulate Matter
- BH1750 I2C Light Sensor
- LTR390 UV Light Sensor
- AM2301B

## Gateway

- ESP32-S3
- MKE-M23 Ra-02 LoRa Module
- Mạch ghi đọc thẻ Micro SD
