iimarky1234/LoRa-Weather-Station/CAD/Prototype_2.dxf

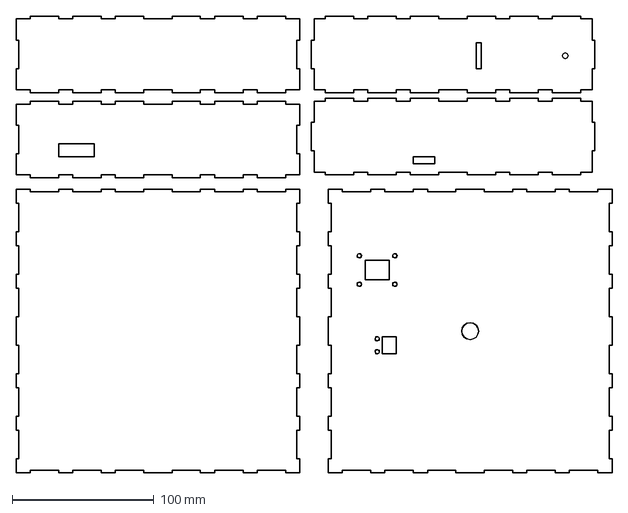
[picture p14: CAD file, 2026-11-01]
CAD/Prototype_2.dxf
420.0 x 322.0 mm
