iimarky1234/LoRa-Weather-Station/CAD/Station.dxf

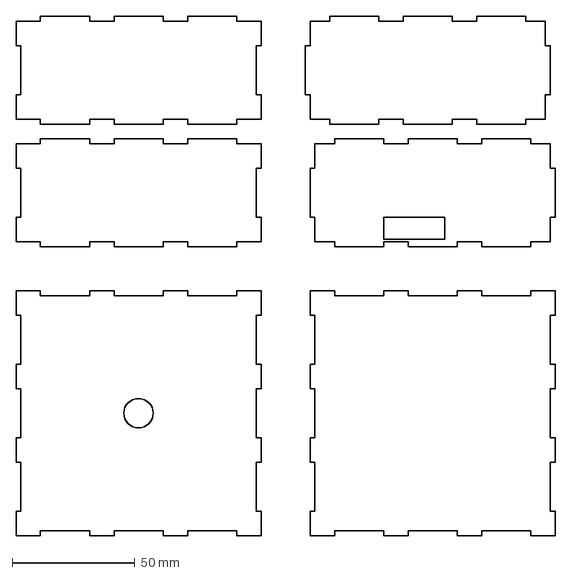
[picture p15: CAD file, 2026-11-01]
CAD/Station.dxf
220.0 x 212.0 mm
