iimarky1234/LoRa-Weather-Station/CAD/edge.dxf

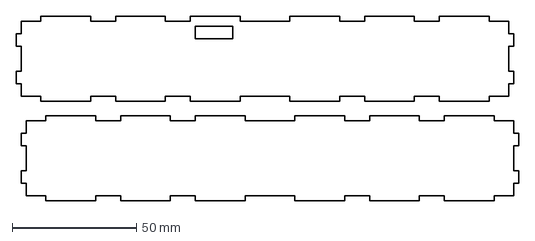
[picture p16: CAD file, 2026-10-26]
CAD/edge.dxf
202.0 x 74.0 mm
