iimarky1234/LoRa-Weather-Station/CAD/Prototype_1.dxf

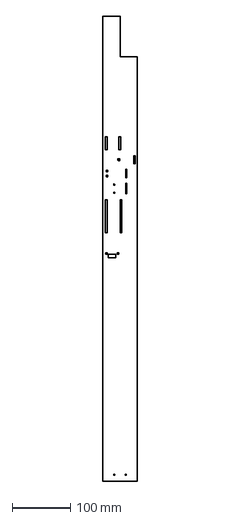
[picture p17: CAD file, 2026-10-26, an earlier design]
CAD/Prototype_1.dxf
60.0 x 800.0 mm
