iimarky1234/LoRa-Weather-Station/docs/FlowChart/Gateway_flowchart.pdf

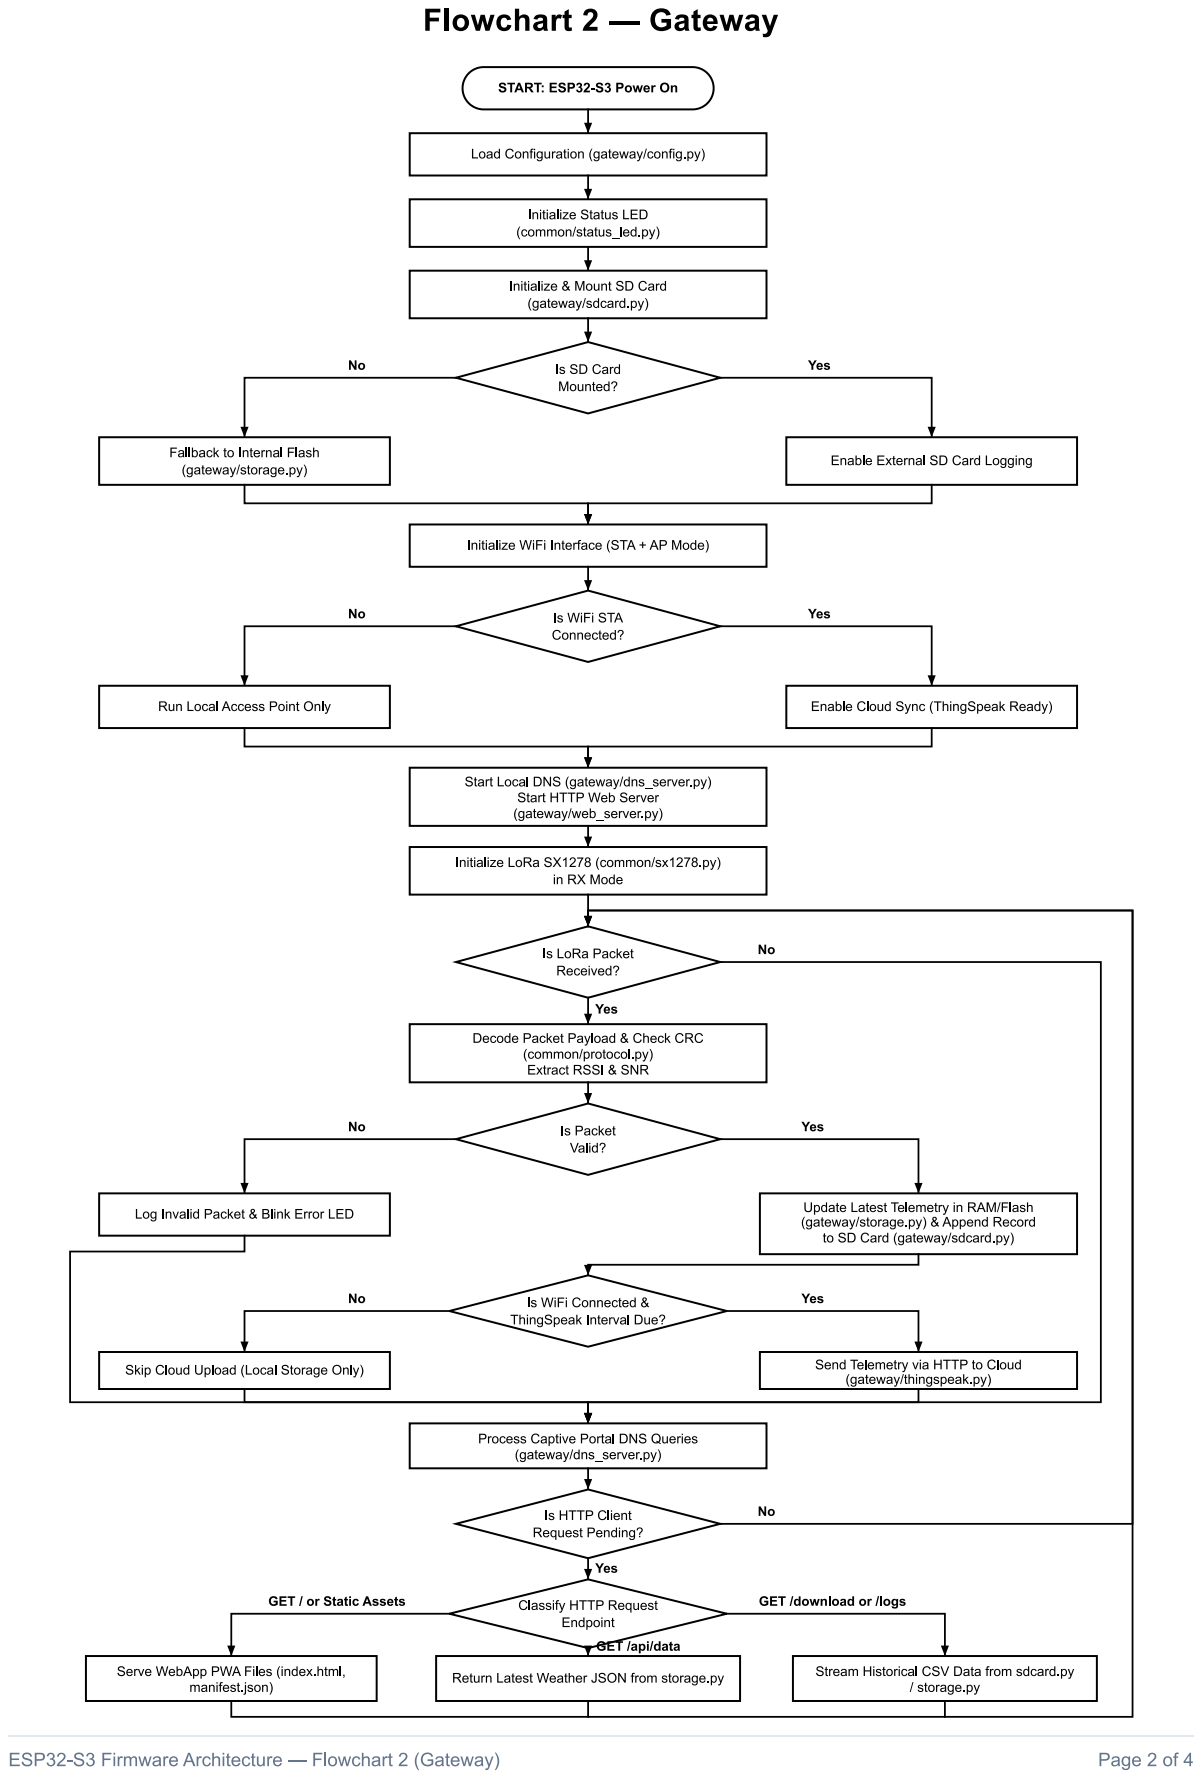
[picture p18: page 1]
