iimarky1234/LoRa-Weather-Station/docs/FlowChart/Node_flowchart.pdf

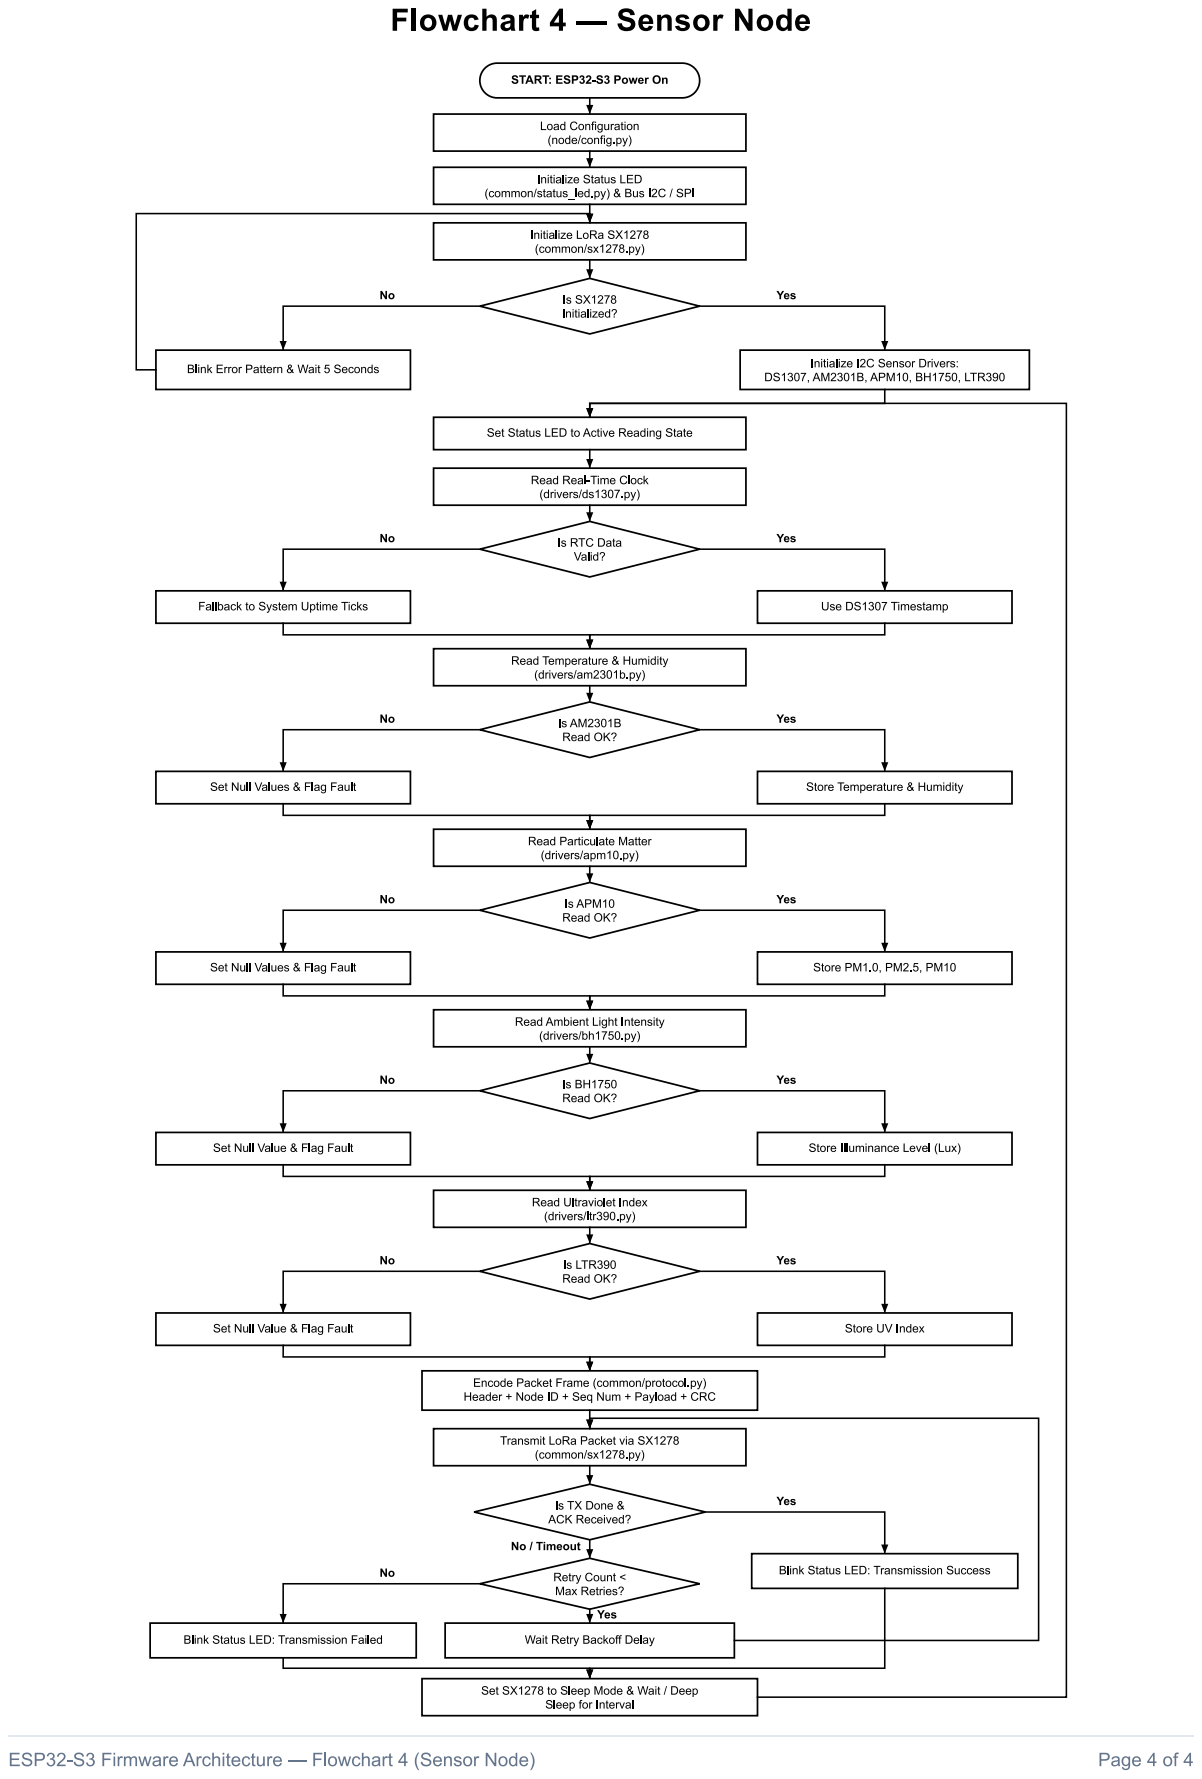
[picture p19: page 1]
