iimarky1234/LoRa-Weather-Station/docs/FlowChart/Repeater_flowchart.pdf

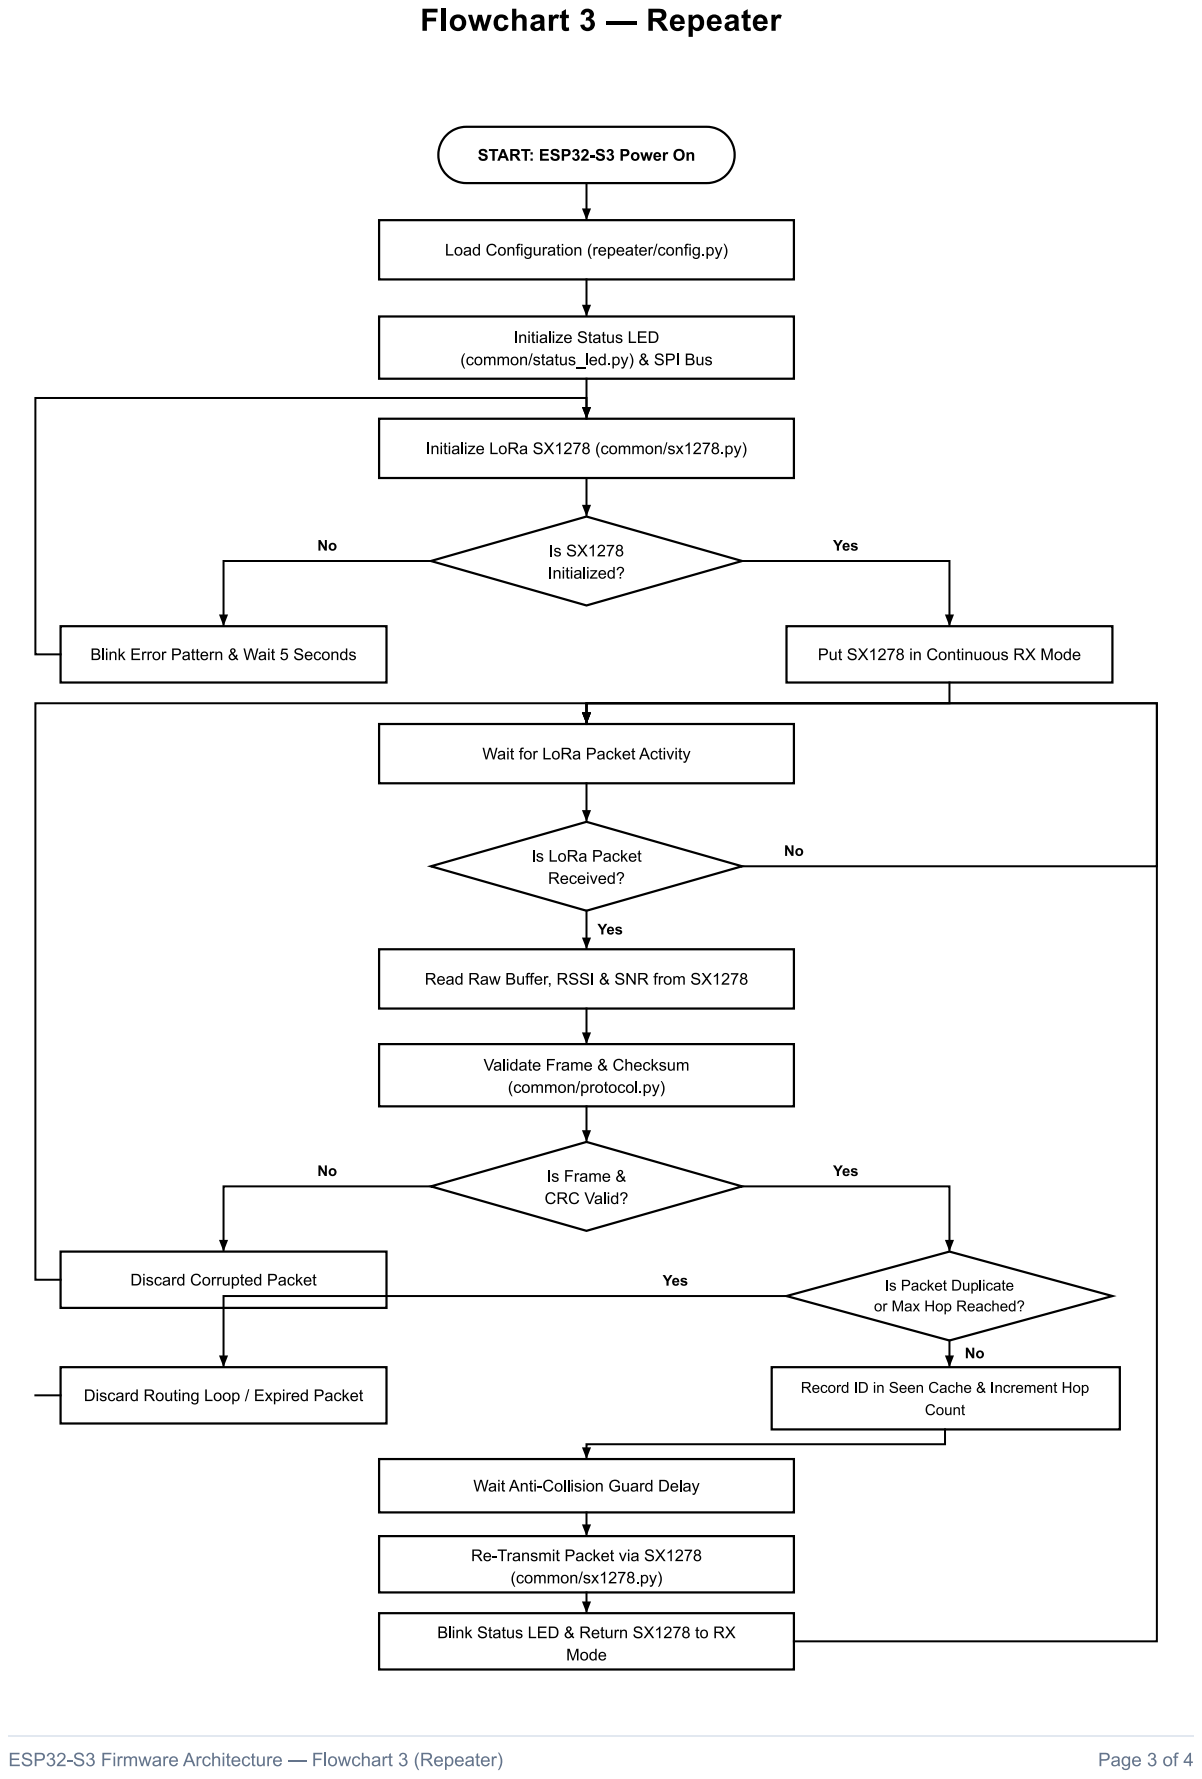
[picture p20: page 1]
