iimarky1234/LoRa-Weather-Station/docs/FlowChart/Standalone_flowchart.pdf

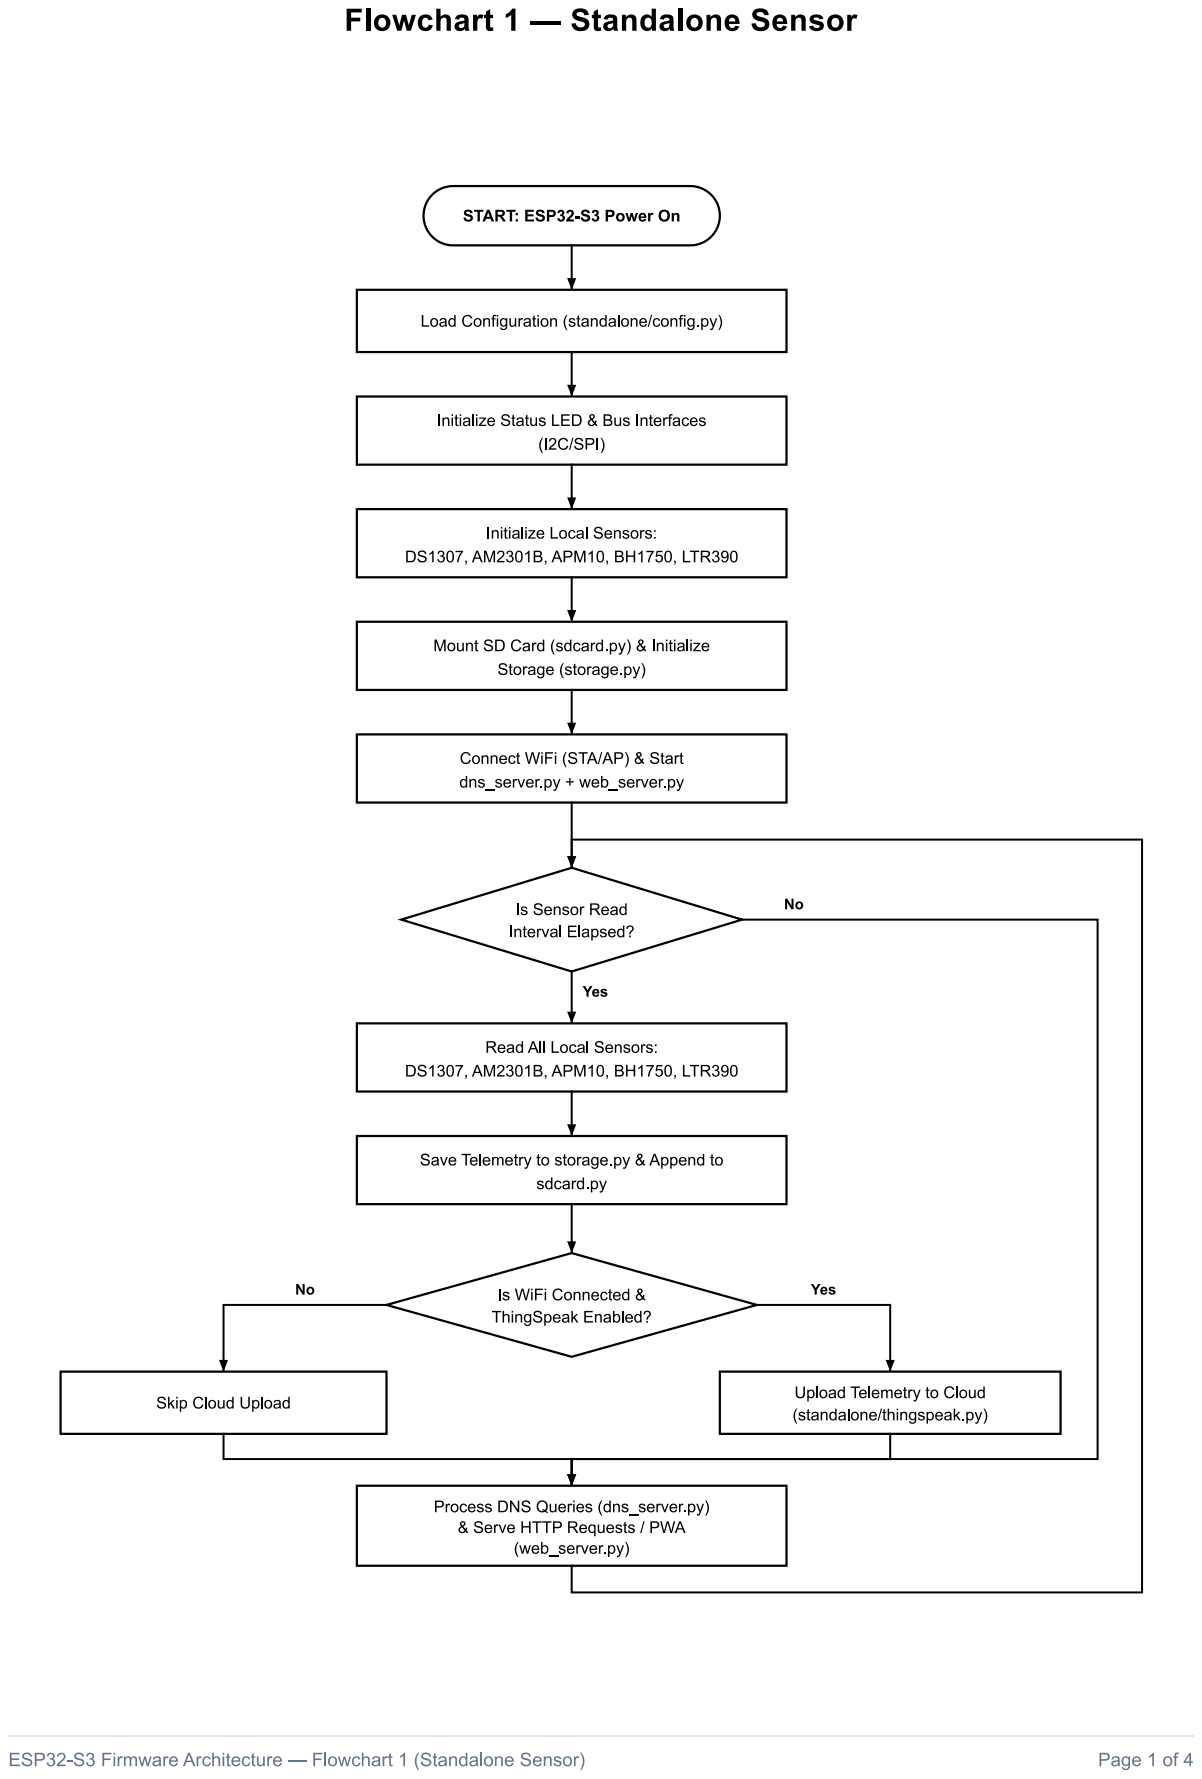
[picture p21: page 1]
