iimarky1234/LoRa-Weather-Station/(commit log)

2026-10-15 First Prototype
    Rearrange repo
    [SCH_Weather-Station-cheap-version_2026-10-14.json]
2026-10-23 Added Flowchart
2026-10-26 Added CAD
    [Prototype_1.dxf, Prototype_2.dxf, edge.dxf]
2026-10-29 Updated new components and schematic
    [SCH_Weather-Station-cheap-version_2026-10-14.json]
2026-10-29 Fixed the RTC issue
    [ds1307.py, main.py]
2026-10-29 feat: track per-node online status by telemetry age and simplify node naming
2026-10-30 Added dns_server
    Trying to fix the local webpage issue cannot load when in AP mode
    [dns_server.py, main.py]
2026-11-01 Added Station CAD design
    [Prototype_2.dxf, Station.dxf]
2026-11-01 Updated firmware
    Removed the soil moisture sensor. Changed APM10 connection from I2C to
    UART. Remove the soil moisture % on webapp
2026-11-02 Updated new schematic
2026-11-05 Added dataset
    simulated run on 3 days
    [gateway_weather_log_simulated.csv]
2026-11-06 Added back soil-moisture
    A
    [gateway_weather_log_simulated.csv]
2026-11-06 Reverted to the old icons
    [gateway_weather_log_simulated.csv]
2026-11-06 Added noise to the logged data
    [gateway_weather_log_simulated.csv]
2026-11-07 Updated dataset
    real :)
    DATASET
    DATASET
    [gateway_weather_log_simulated.csv]
2026-11-08 docs: add system architecture flowcharts PDF
2026-11-09 Removed the old flowcharts and seperated the new flowcharts
